Kuba-Dvorak/PCB_Maker/documentation/commProtocol.txt

========================================================================
 KOMUNIKACNI PROTOKOL
========================================================================

Retez: frontend (browser)  <--HTTP-->  backend (Node, port 3300)
       backend             <--TCP-->   nanoComm (C++, porty 5000 / 5001)
       nanoComm            <--UART-->  Nano (115200 8-N-1)

------------------------------------------------------------------------
 TCP mezi backendem a nanoComm
------------------------------------------------------------------------

port 5000 = prikazy a reporty
port 5001 = emergency

zacatek zpravy: $
konec zpravy:   \n

emergency znaky (port 5001):
  ; = pause
  # = stop

------------------------------------------------------------------------
 CMD cisla pro Nano
------------------------------------------------------------------------

0   ping / otestovani linky
1   jednoduchy move (X, Y)
2   nastaveni otacek spindlu
3   homing na MIN vsech osy
4   homing na MAX vsech osy
5   zvednout Z, pak jet (pokracovani v jobu)
6   vypnout spindl
7   ukonceni jobu: spindl off + homing na MAX
8   relativni move (prictene k aktualni pozici)
12  zadny prikaz, Nano preskoci a NEPOSILA report
25  interni: loadCMD nedokazal zpravu rozparsovat
255 stejne jako 7

POZOR: cmd 12 je jediny prikaz, ktery neposila report. Vsechny ostatni
report posilaji, a nanoComm na nej ceka v listenUART().

------------------------------------------------------------------------
 Emergency kody z frontendu
------------------------------------------------------------------------

stop:  4
end:   5   (dojede homing na max X, max Y, max Z)

------------------------------------------------------------------------
 Format reportu Nano -> nanoComm
------------------------------------------------------------------------

$status;error;x;y;z;speed;spindleSpeed;endstops;\n

Vsechny nekonstantni ciselne polozky krome status/error/endstops se
posilaji jako CELE CISLO vynasobene 100 (float printf na avr-libc bez
-lprintf_flt tiskne jen '?'). nanoComm je pri parsovani deli zpet 100.

Priklad: X = 12.34 mm  ->  1234

------------------------------------------------------------------------
 POTVRZOVANI (UART, obema smery)
------------------------------------------------------------------------

Kazdy prikaz i kazdy report se pred pouzitim posle zpatky a porovna.
Nic se neprovede ani nepouzije, dokud druha strana nepotvrdi, ze prijala
to, co se poslalo. Nahrazuje to drivejsi paritu, ktera hlidala jen cislo
prikazu, status, error a endstopy - souradnice ne.

Ramec na UARTu:  $$$ <data> \n\n\n
  Prijemci staci najit aspon jeden '$' - kdyz rusi poskodi prvni jeden
  nebo dva, ramec se porad pozna. Za '$' parser preskoci vsechno, co neni
  cislice, a skoci rovnou na prvni cislo. Konec: kdyz se prvni '\n'
  poskodi, ramec ukonci druhy.
  (TCP ramec mezi nanoComm a backendem je dal $<json>\n, ten se nemenil.)

Prikaz (nanoComm -> Nano):
  1. nanoComm posle   $$$cmd;x;y;z;speed;spindleSpeed;\n\n\n   (floaty, %f)
  2. Nano posle echo  $$$cmd;x;y;z;speed;spindleSpeed;\n\n\n   (cela cisla
                      x100, zaokrouhlena lround)
  3. nanoComm porovna (sameCMDs, tolerance 0.05) a posle potvrzeni
  4. Nano prikaz provede jen na "ano". Na "ne", na timeout (1 s) i na
     cokoliv, co nevypada jako potvrzeni, ho zahodi bez reportu.
     nanoComm ho po "ne" posle znovu.

  Tolerance 0.05: v XY je to min nez jeden krok (0.08 mm), takze takova
  odchylka stroj stejne nepohne jinam. V Z je to ale 10 kroku (krok
  0.005 mm) - radove tloustka medi na desce (35 um).

Report (Nano -> nanoComm):
  1. Nano posle report (tvar viz vys, jen s $$$ a \n\n\n)
  2. nanoComm posle echo  $$$status;error;x;y;z;speed;spindl;endstops;\n\n\n
                          (x..spindl uz v mm, floaty %f)
  3. Nano porovna v setinach (sameReports: long(x*100) == lround(echo*100),
     takze bez tolerance) a posle potvrzeni
  4. Na "ne" nebo kdyz echo neprijde, posle Nano report znovu - nejvys
     maxReportAttempts = 3 krat, pak to vzda a ceka na dalsi prikaz.
     Nano nesmi viset: kdyby nanoComm report necetl, nevzalo by uz nic.

Potvrzeni:  $$$ + 14x stejna cifra + \n\n\n,  tedy 20 B
            1 = ano, 0 = ne. Rozhoduje vetsina (hasMajority), remiza je ne.
            Presna delka se nehlida - rusi muze bajt zahodit nebo pridat.
            Za potvrzeni se ale bere jen ramec BEZ ';' (prikaz i report ho
            maji vzdy) a na Nanu jen s aspon 10 ciframi 0/1.

Velikosti jsou na obou stranach stejne:
  largeMessageStandart        80   nejdelsi ramec ma i s $$$ a \n\n\n 66 B
                                   (echo reportu od nanoComm)
  conformationMessageStandart 20   potvrzeni

ZNAMA DIRA: kdyz se ztrati cele potvrzeni prikazu, nanoComm si mysli
"ano", Nano "ne". Nano prikaz neprovede a nanoComm ceka na report, ktery
neprijde - az do timeoutu v listenUART (error 17). Nic spatneho se
neprovede, jen se to zastavi.

------------------------------------------------------------------------
 STATUS - kdo report poslal
------------------------------------------------------------------------

0   Nano
1   nanoComm (C++)
2   backend (JS)
3   frontend (browser)

Status 3 se po drate nikdy neposle. Dopisuje si ho stranka sama v okamziku,
kdy spojeni s backendem nestoji - tedy kdyz uz nema od koho zadny report
dostat. Vsechna cisla na strance jsou pak posledni znamy stav, ne aktualni,
a koncaky jdou do sedive.

Status je nutny k precteni erroru. Stejne cislo erroru znamena u kazdeho
zdroje neco jineho (napr. 6 a 7 se pouzivaji u Nana i u nanoComm jinak).

------------------------------------------------------------------------
 ERROR kody
------------------------------------------------------------------------

--- status 0, hlasi Nano -----------------------------------------------

0    OK, prikaz dobehl bez problemu
3    Nano neumelo prijatou zpravu rozparsovat (poskozeny frame)
4    odpoved na ping (neni to chyba, jen potvrzeni ze Nano zije)
5    nezname cislo prikazu
6    cil byl mimo pracovni prostor, byl clampnuty na nejblizsi hranu
     -> stroj jel jinam, nez frontend chtel
7    behem pohybu byl stisknut koncak, nebo stroj nikdy nebyl homovany
     -> reportovana pozice uz neni verohodna, je potreba homovat
8    ukonceni jobu: spindl vypnuty, vsechny osy homovane na max
10   stisknuto emergency tlacitko (hardwarovy interrupt)
     -> motory a spindl vypnute, timer1 zastaveny

--- status 1, hlasi nanoComm (C++) -------------------------------------

0    OK, komunikace bezi
1    pozadovany soubor s G-kodem nebyl nalezen na disku
2    UART je uz obsazeny, prikaz byl zahozeny
3    pohyb odmitnut, stroj neni homovany (prikaz se na UART vubec neposlal)
6    Nano se odpojilo od serioveho portu pri cteni reportu
7    seriovy port neni otevreny
10   job skoncil driv, nez dosel soubor: Nano vratilo chybu, nebo uz
     neodpovida. Spindl ani homing uz se neresi, job je pryc.
17   od Nana neprisel cely report do timeoutu listenUART (600 s,
     pri opakovani 60 s). Nano je zaseknute, odpojene, nebo se ztratilo
     potvrzeni prikazu - viz ZNAMA DIRA u potvrzovani.
11   job dojel az na konec souboru, odeslan cmd 7/255
     -> spindl vypnuty a vsechny osy homovane na max

Dve cisla nejsou chyby, jen znacky. Nesou informaci navic a poznaji se
prave podle toho cisla, jinak vypadaji jako obycejny report:

162  odhad celkoveho casu jobu. nanoComm kazdych 40 volani doGcodeTask
     zmeri, kolik casu zatim ubehlo; cas/40 * pocet radku souboru da
     odhad celku. Pocet radku drzi gcodeDecoder (totalLines).
163  prereport - stav, ktery nanoComm posle dopredu, jeste nez ho
     potvrdi Nano. Backend ho nezapisuje do currentReport, jen ho
     preposle na frontend jako cmdBE 3. Slouzi k vykresleni, ne k
     hlaseni stavu.

--- status 2, hlasi backend (JS) ---------------------------------------

0    backend jeste nedostal zadny report ze stroje
1    frontend poslal neco, co neni platny JSON
2    frontend poslal prikaz, kteremu backend nerozumi
     (nezname cmd nebo subCmd, chybejici cislo)
3    prikaz odmitnut, prave bezi job
     -> jog i homing jsou behem jobu zamcene. Behem PAUZY povolene jsou,
        prave kvuli vymene hrotu.
4    G-kod se nepodarilo vygenerovat, tisk nezacal
5    prikaz se nikam neodeslal, nanoComm neni pripojeny
33   nanoComm poslal neco, co neni platny JSON
34   nanoComm poslal zpravu bez uvodniho znaku $

Cisla 1 az 5 vznikaji v backendu jeste pred tim, nez se ke stroji cokoliv
posle. Ke stroji se v tu chvili nic nedostalo, takze by na report nebylo
od koho cekat - proto si ho backend posle sam.

--- status 3, hlasi frontend -------------------------------------------

0    spojeni s backendem jeste nebylo navazano (stranka se prave otevrela)
1    spojeni s backendem se zavrelo
2    spojeni s backendem se nepodarilo otevrit
     -> bezi server vubec, a sedi adresa v connectedURL?

------------------------------------------------------------------------
 ENDSTOPS - bitova maska stisku koncaku
------------------------------------------------------------------------

Osma polozka reportu. Bitova maska, ktera rika, ktere koncaky byly
stisknute BEHEM POSLEDNIHO PRIKAZU. Je latchovana (sticky): staci jeden
stisk kdykoliv v prubehu pohybu a bit zustane nastaveny az do dalsiho
prikazu. Nezajima nas kolikrat, jen jestli vubec.

  bit 0   hodnota 1    X min   (esXFront)
  bit 1   hodnota 2    X max   (esXEnd)
  bit 2   hodnota 4    Y min   (esYFront)
  bit 3   hodnota 8    Y max   (esYEnd)
  bit 4   hodnota 16   Z min   (esZFront)
  bit 5   hodnota 32   Z max   (esZEnd)

  0    zadny koncak nebyl stisknuty
  -1   stav koncaku neni znamy (backend jeste nic nedostal, nebo report
       polozku endstops neobsahoval)

Poradi bitu kopiruje poradi parametru v setupPins(): front (min) pak
end (max), a osy X -> Y -> Z.

Priklad: 9 = 1 + 8 = behem posledniho pohybu byl stisknuty X min a Y max.

Kde se maska nastavuje:
  - nuluje se v operateInstr() vedle currentError = 0
  - OR-uje se v interuptX/Y/Z() tam, kde se uz dneska nastavuje
    homed = false

Proc samostatna polozka a ne cast erroru: error potrebuje 4 bity
(hodnoty 0-10), maska 6 bitu, dohromady 10 bitu a to se do jednoho
bajtu nevejde. Frame ma navic misto - typicky report ma ~36 znaku
pri bufferu 64 B, takze jedna polozka navic je bezpecna.

------------------------------------------------------------------------
 Poznamka k zapojeni koncaku
------------------------------------------------------------------------

Koncaky jsou na INPUT_PULLUP a firmware cte LOW = stisknuto. Z toho
plyne, ze NA D13 KONCAK NESMI BYT: na Nanu je tam onboard LED zapojena
primo (na rozdil od Uno R3, kde je mezi tim buffer), interni pullup ji
neprepere a pin cte natrvalo LOW. Osa pak stoji a nikdy neudela krok.

Zapojeni je NO (rozpinaci do GND), takze "nestisknuto" = HIGH. Preruseny
kabel proto vypada jako "vse v poradku" - stroj tise prijde o ochranu.
NC zapojeni selhava bezpecnym smerem, je to jen otoceni podminky
v interupt*().
