Kuba-Dvorak/PCB_Maker/documentation/protocolBackFronNano.txt

$$$
status: "int", error: "int", x: "float", y: "float", z: "float", speed: "float", spindlSpeed: "float", endstops: "uint_8"
\n\n\n
