Kuba-Dvorak/PCB_Maker/documentation/protocolForNano.txt

$$$
cmd: "int", x: "float", y: "float", z: "float", speed: "float", spindleSpeed: "float"
\n\n\n
