Kuba-Dvorak/PCB_Maker/obrazek2.png

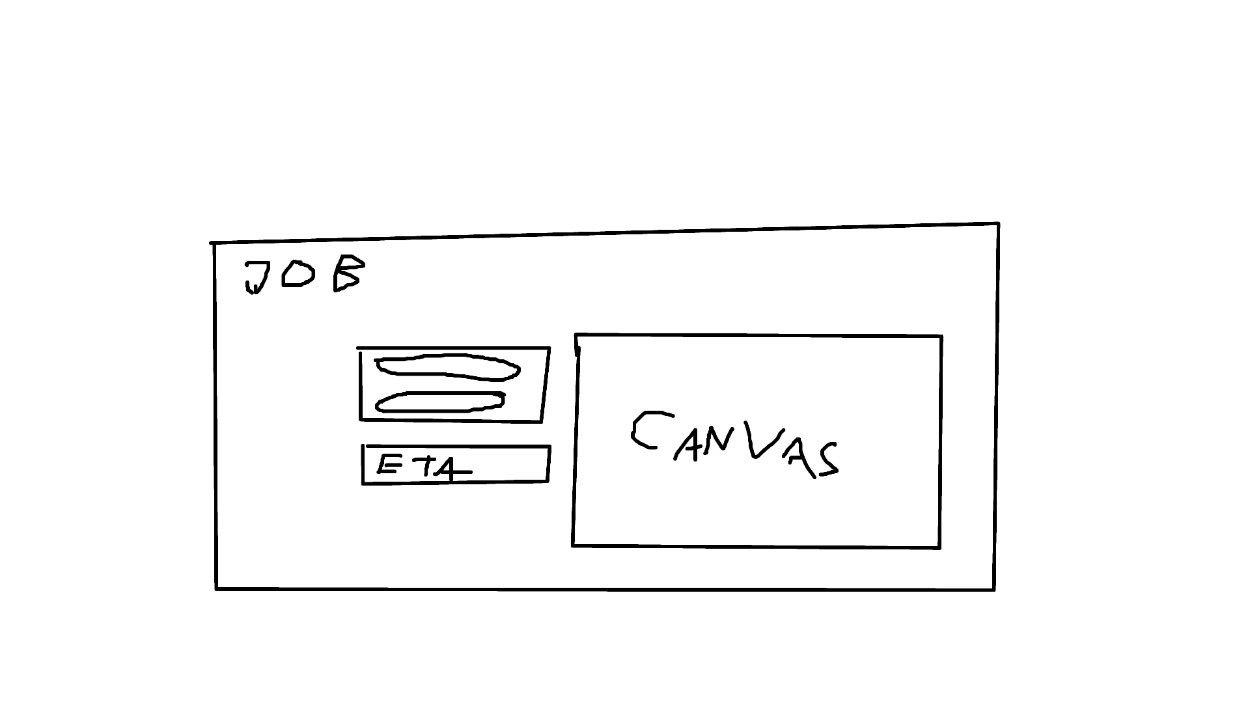
obrazek2.png
