Kuba-Dvorak/PCB_Maker/obrazek3.png

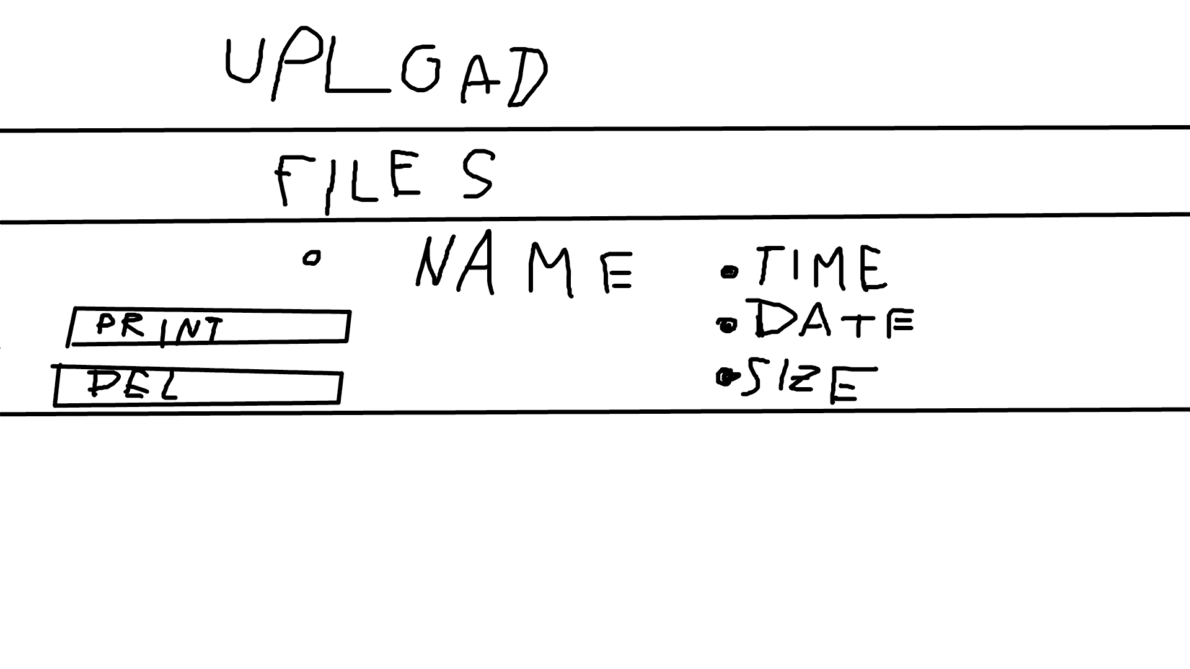
obrazek3.png
