Kuba-Dvorak/PCB_Maker/obrazek4.png

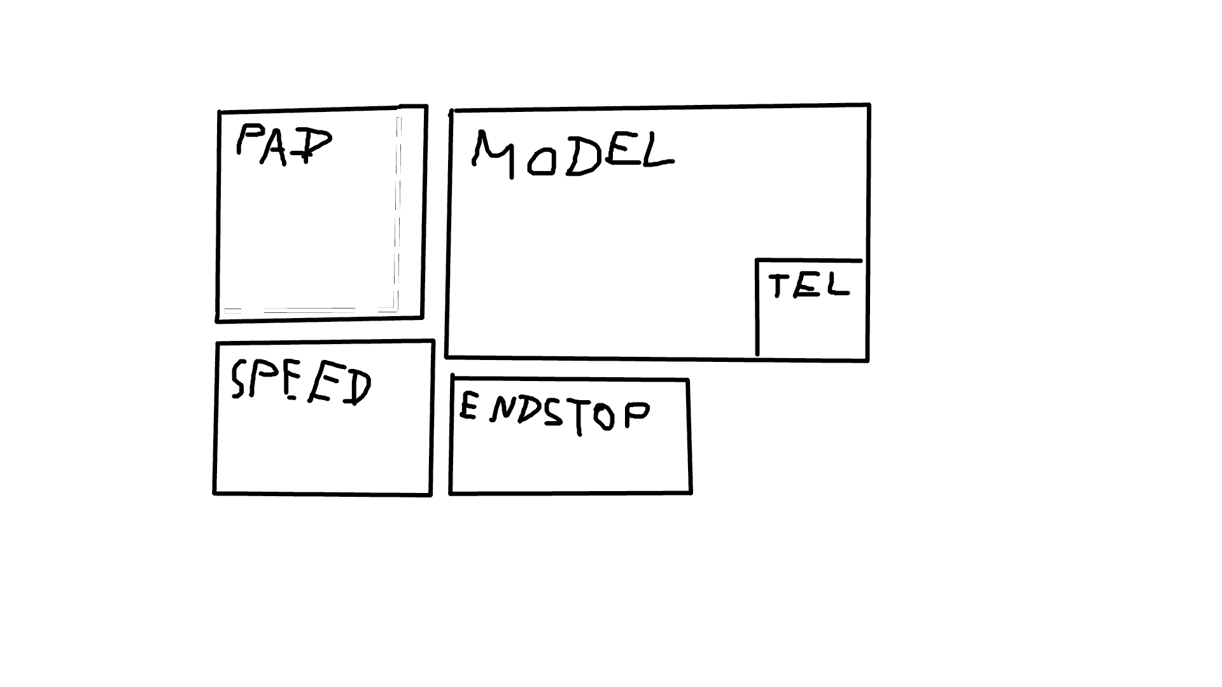
obrazek4.png
