Kuba-Dvorak/PCB_Maker/obrazek.png

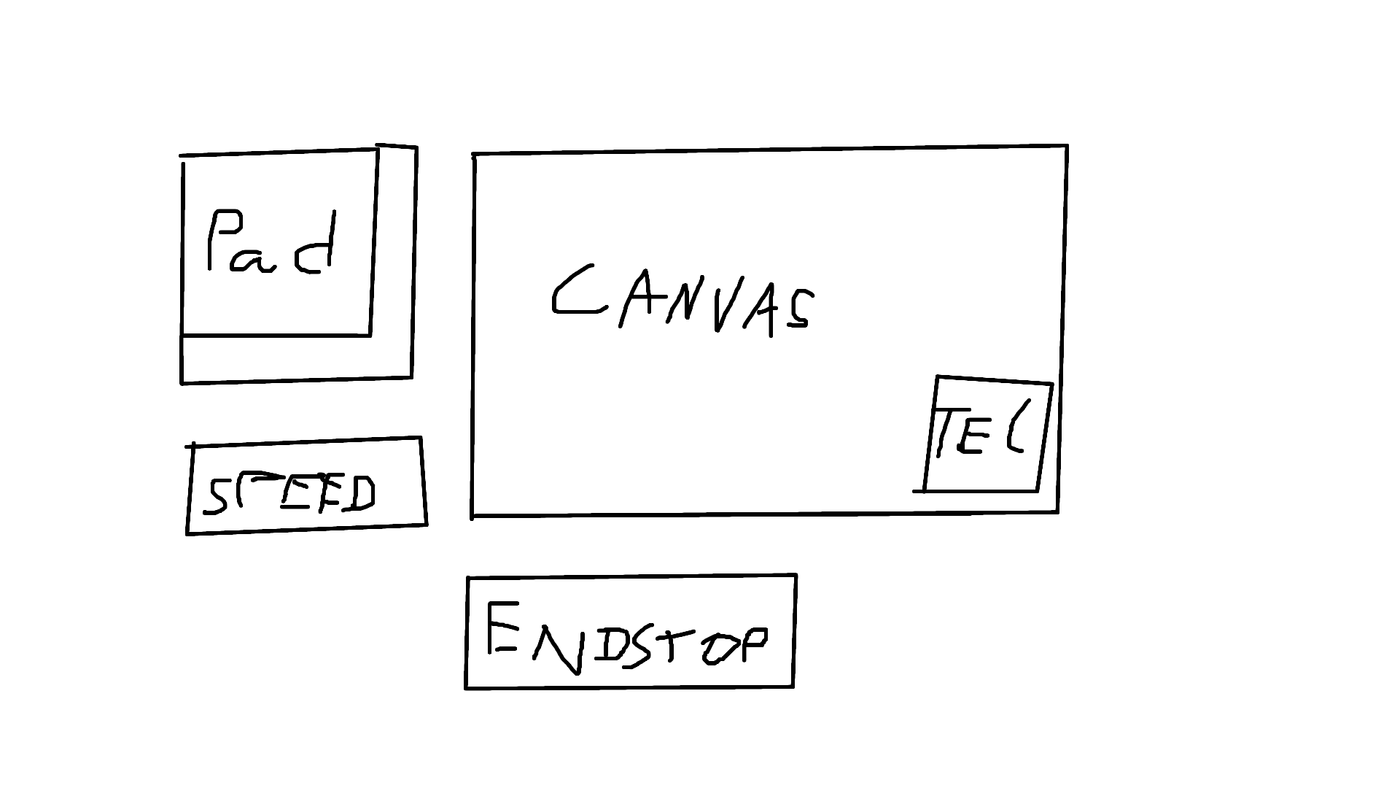
obrazek.png
