Kuba-Dvorak/PCB_Maker/showimage2.png

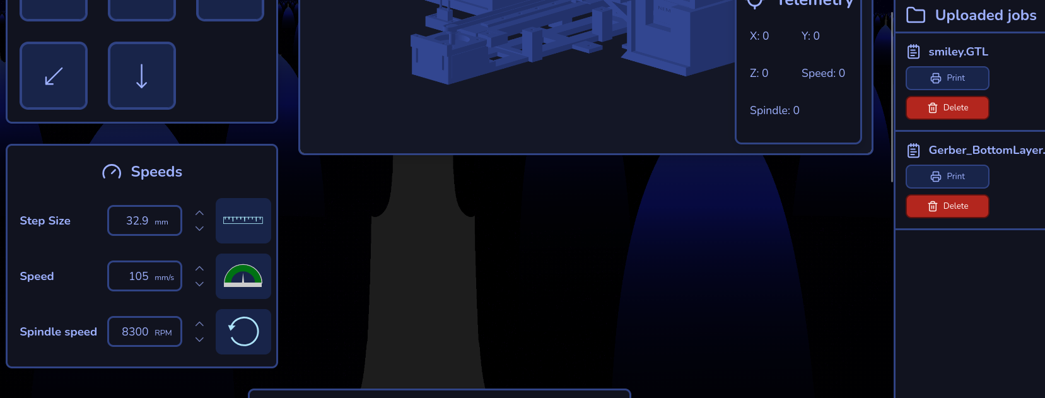
showimage2.png
