Kuba-Dvorak/PCB_Maker/showObraz3.png

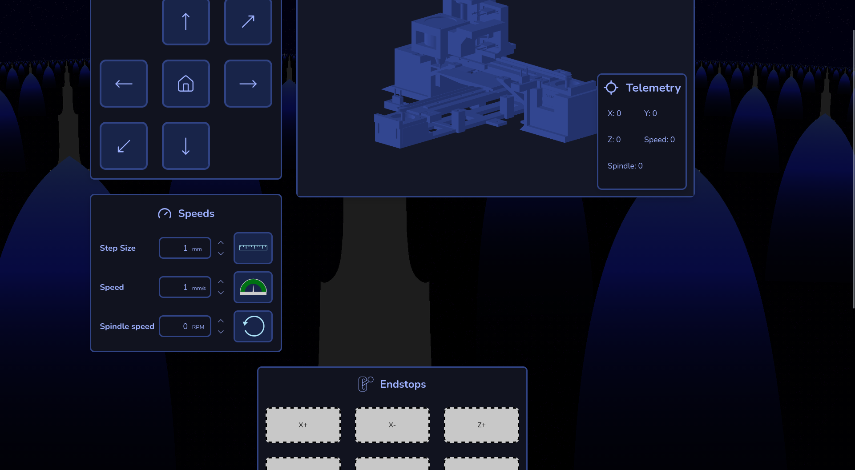
showObraz3.png
