Kuba-Dvorak/PCB_Maker/showobrazek.png

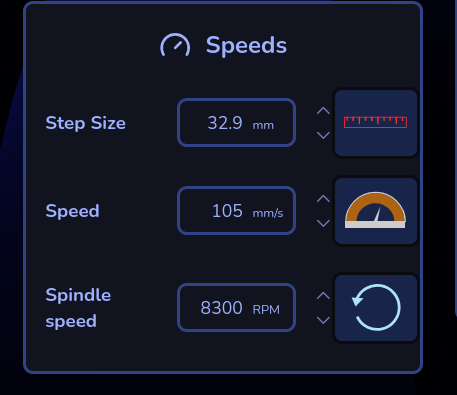
showobrazek.png
