Kuba-Dvorak/PCB_Maker/webdisajn2.png

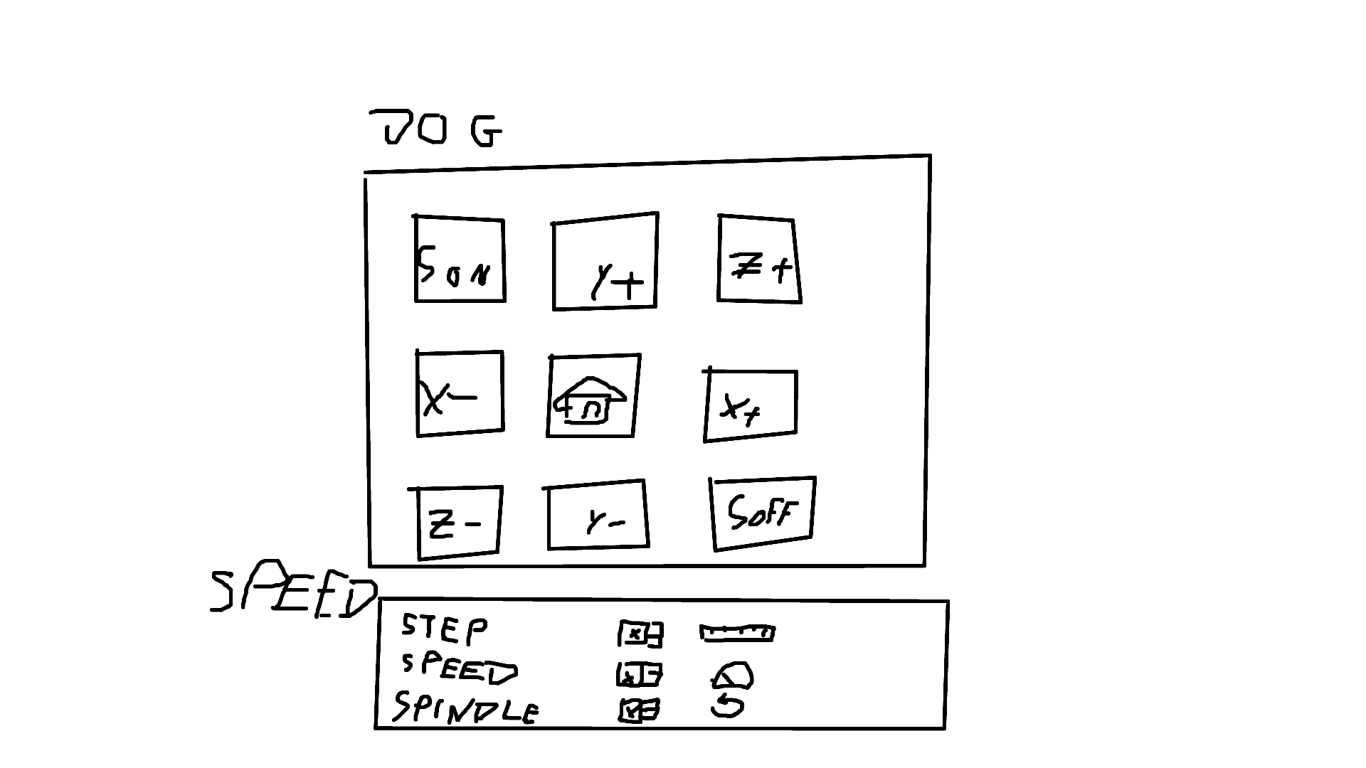
webdisajn2.png
