Kuba-Dvorak/PCB_Maker/webDisajn.png

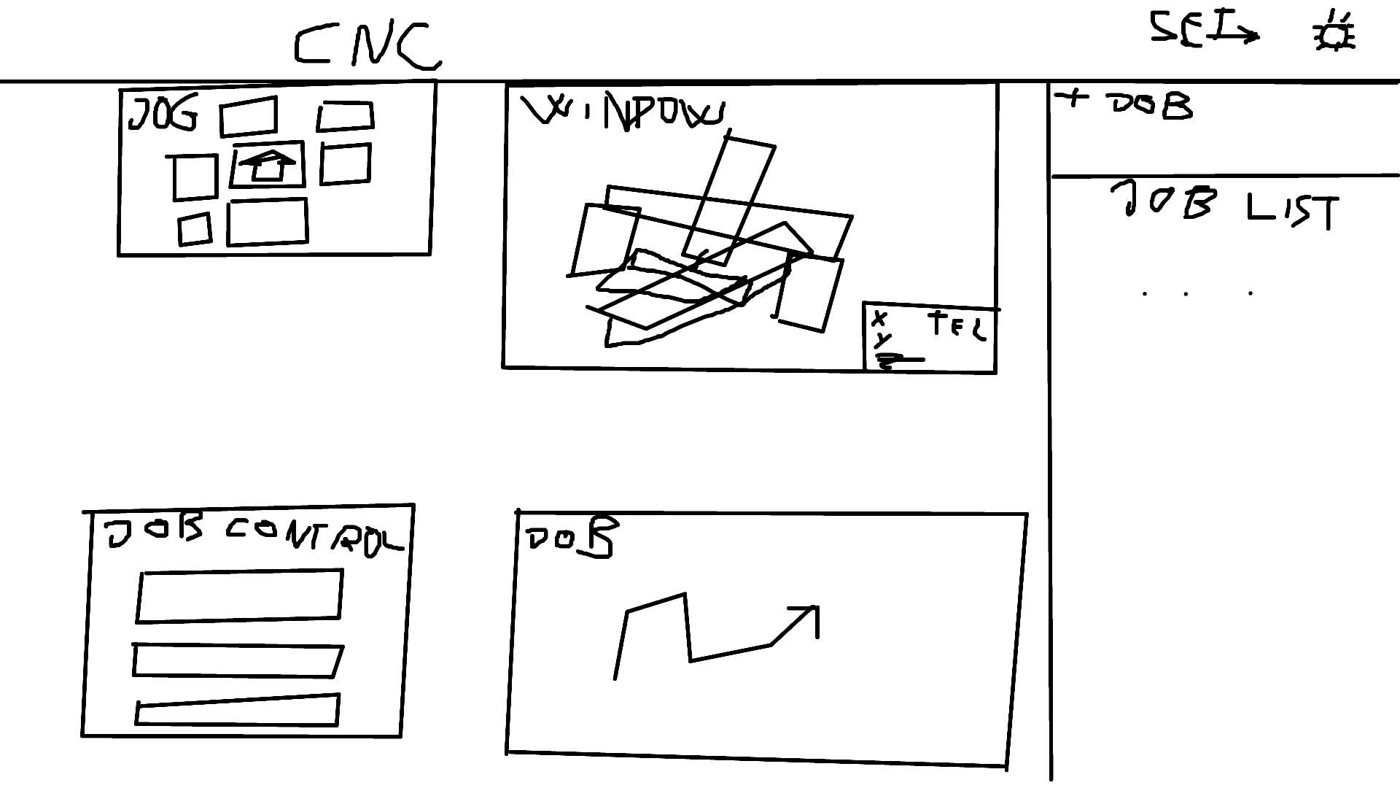
webDisajn.png
