Kuba-Dvorak/PCB_Maker/webUI/frontend/backgrounds-default/ComplexGraph.png

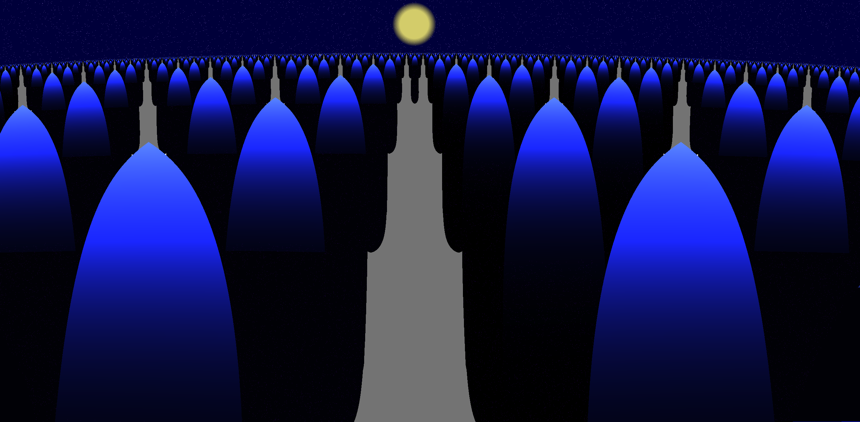
webUI/frontend/backgrounds-default/ComplexGraph.png
