Kuba-Dvorak/PCB_Maker/models/idlerHolderXaxis.stl

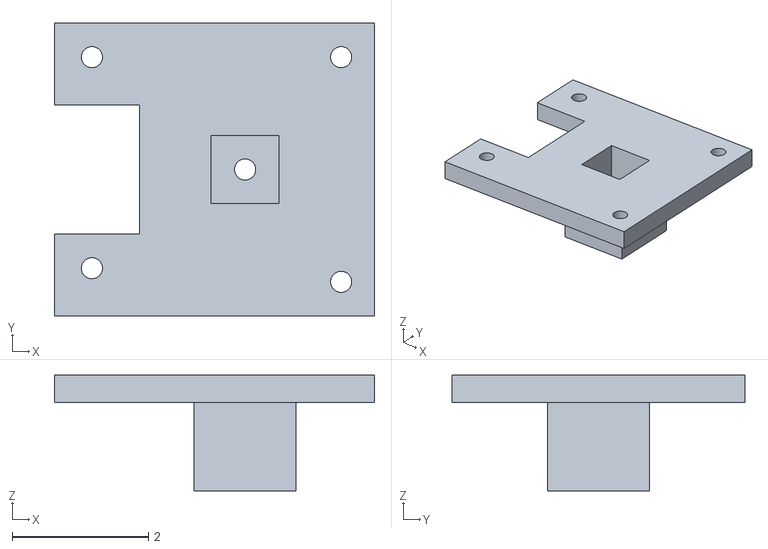
[picture p11: CAD file, 2026-07-24]
models/idlerHolderXaxis.stl
4.70 x 4.30 x 1.70
