Kuba-Dvorak/PCB_Maker/webUI/frontend/models/cartX.stl

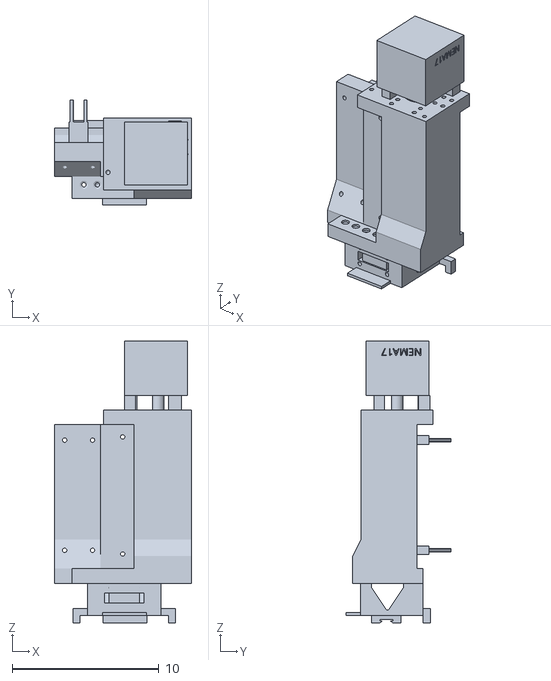
[picture p12: CAD file, 2026-09-15]
webUI/frontend/models/cartX.stl
9.34 x 7.15 x 19.2
