Kuba-Dvorak/PCB_Maker/models/motorHolderTop.stl

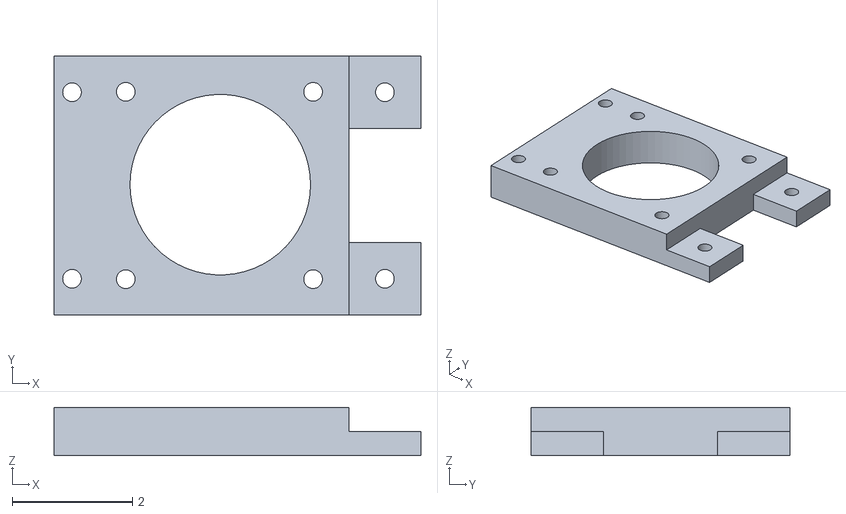
[picture p13: CAD file, 2026-07-06]
models/motorHolderTop.stl
6.10 x 4.30 x 0.8
