Kuba-Dvorak/PCB_Maker/webUI/frontend/models/cartZ.stl

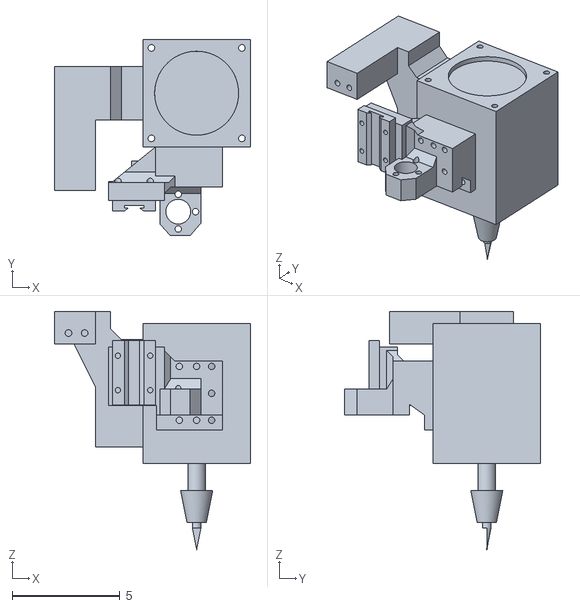
[picture p14: CAD file, 2026-09-15]
webUI/frontend/models/cartZ.stl
9.10 x 9.11 x 11.1
