Kuba-Dvorak/PCB_Maker/models/motorHolderBottom.stl

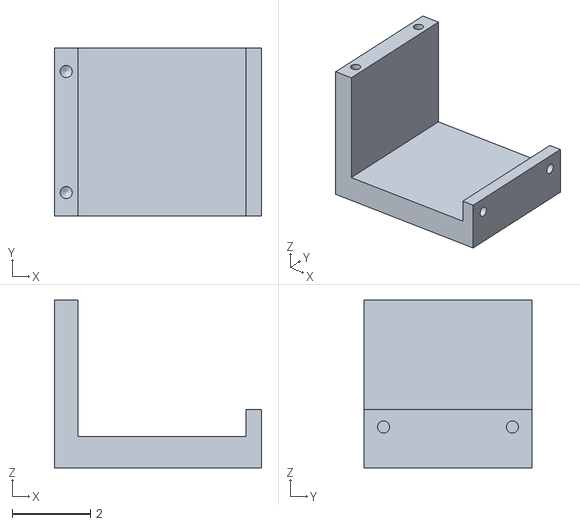
[picture p15: CAD file, 2026-07-06]
models/motorHolderBottom.stl
5.30 x 4.30 x 4.30
