Kuba-Dvorak/PCB_Maker/webUI/frontend/models/cartY.stl

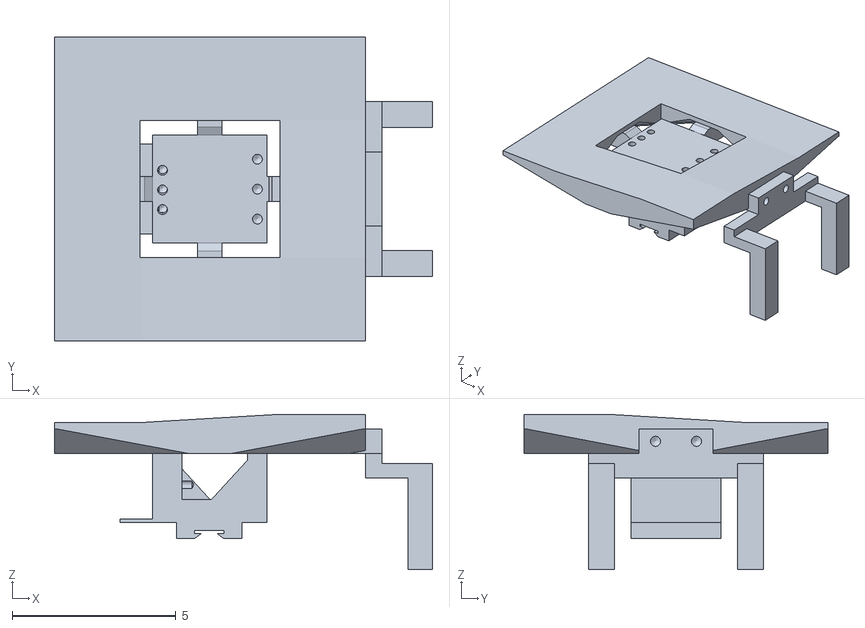
[picture p16: CAD file, 2026-09-15]
webUI/frontend/models/cartY.stl
11.6 x 9.30 x 4.75
