Kuba-Dvorak/PCB_Maker/models/rail.stl

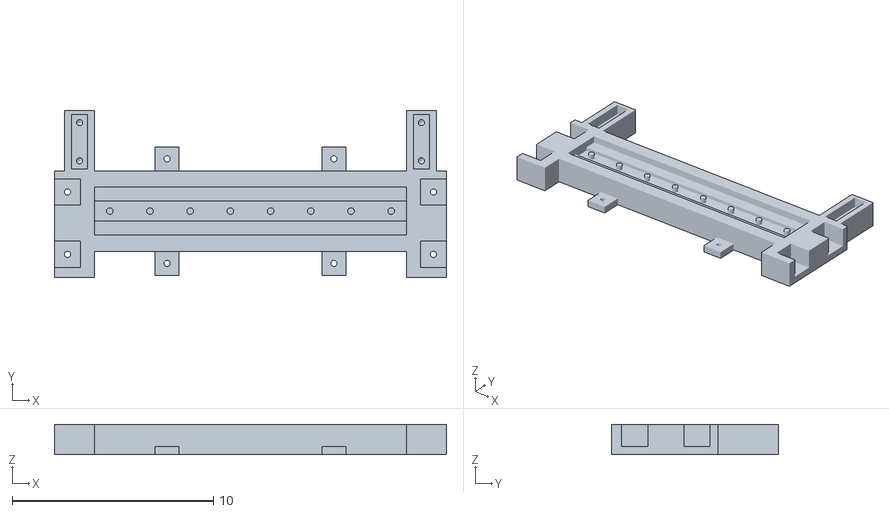
[picture p17: CAD file, 2026-07-06]
models/rail.stl
19.5 x 8.30 x 1.50
