Kuba-Dvorak/PCB_Maker/webUI/frontend/models/staticPart.stl

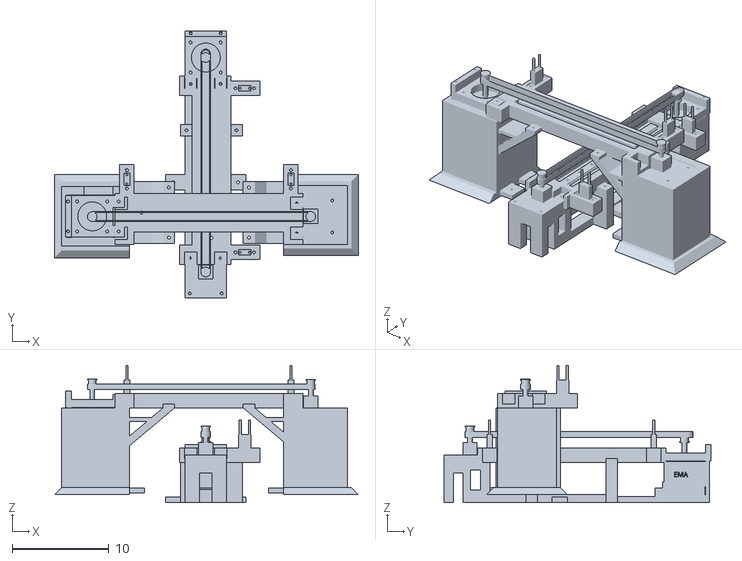
[picture p18: CAD file, 2026-09-15]
webUI/frontend/models/staticPart.stl
31.5 x 27.7 x 14.2
