Kuba-Dvorak/PCB_Maker/models/EndstopPin.stl

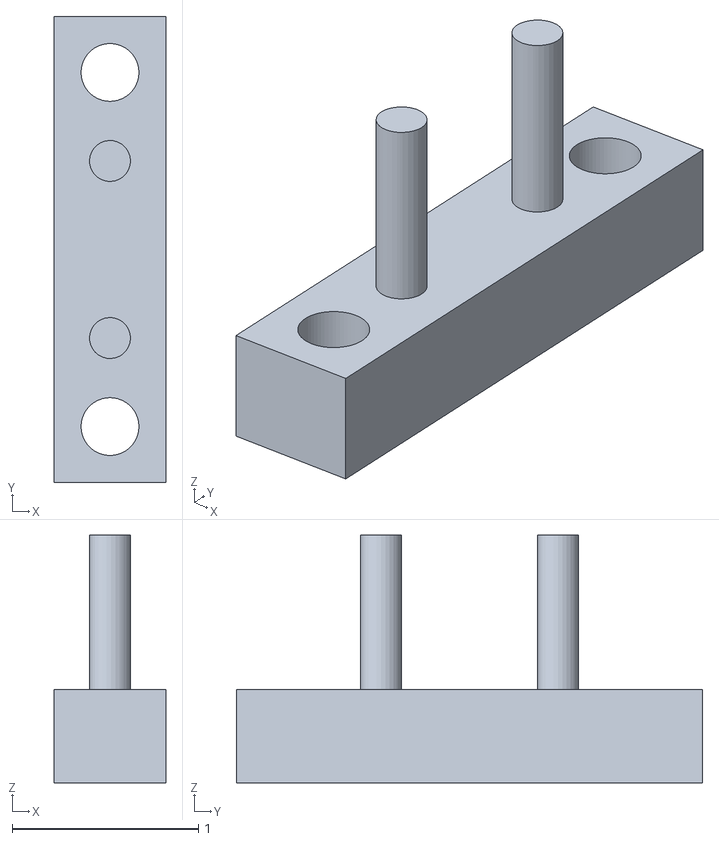
[picture p19: CAD file, 2026-07-06]
models/EndstopPin.stl
0.6 x 2.50 x 1.33
