Kuba-Dvorak/PCB_Maker/models/beltclampSmall.stl

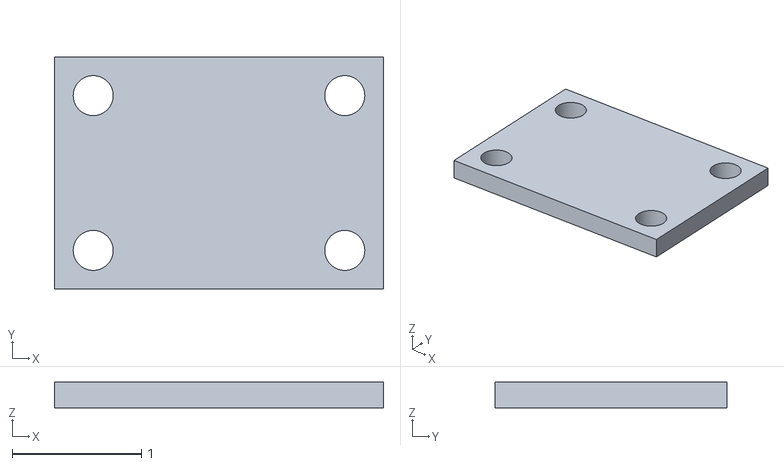
[picture p20: CAD file, 2026-07-06]
models/beltclampSmall.stl
2.55 x 1.80 x 0.2
