Kuba-Dvorak/PCB_Maker/models/beltClamp.stl

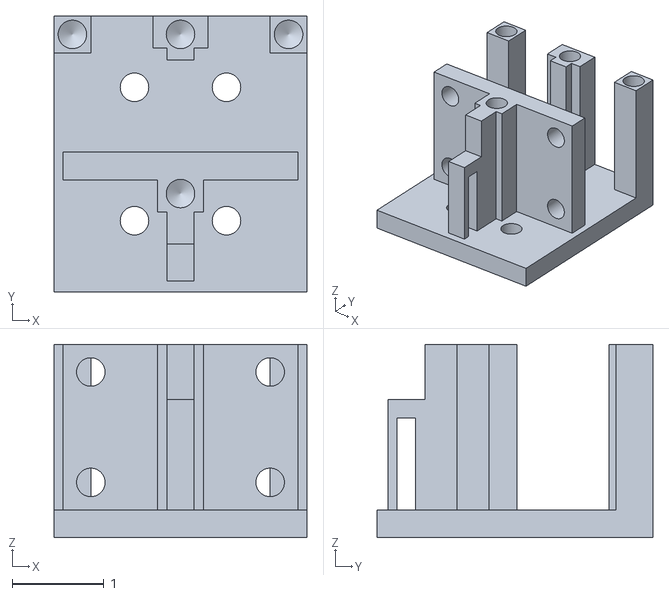
[picture p21: CAD file, 2026-07-06]
models/beltClamp.stl
2.75 x 3.00 x 2.10
