Kuba-Dvorak/PCB_Maker/models/base.stl

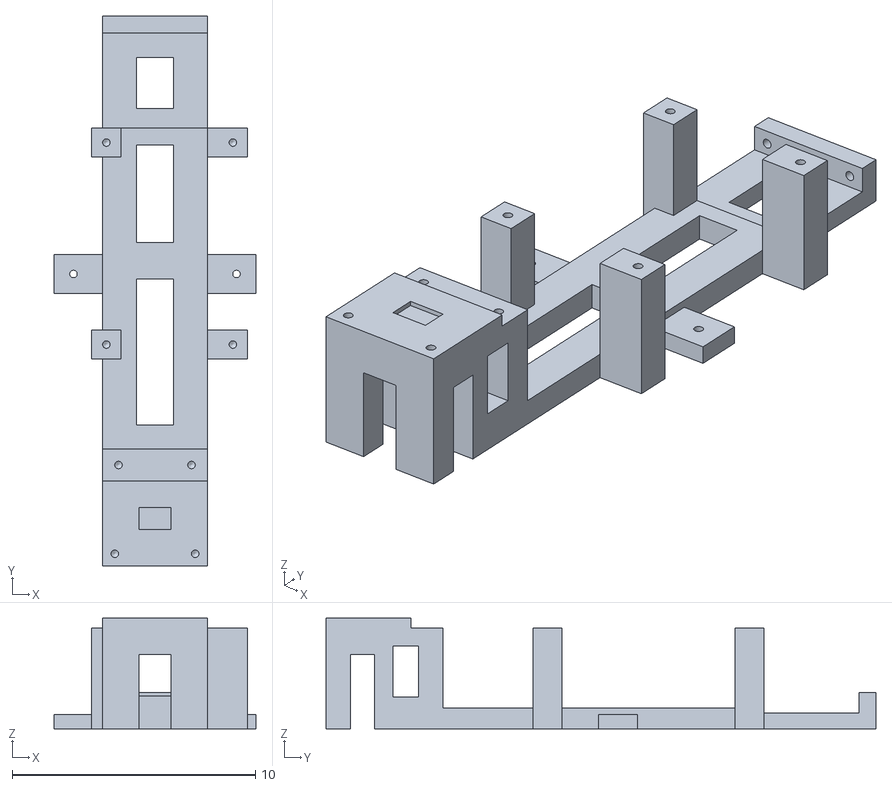
[picture p22: CAD file, 2026-07-06]
models/base.stl
8.30 x 22.6 x 4.55
