Kuba-Dvorak/PCB_Maker/pcb_for_cnc_for_pcb/board/board.kicad_pcb

## KiCad design pcb_for_cnc_for_pcb/board/board.kicad_pcb (2026-09-08)

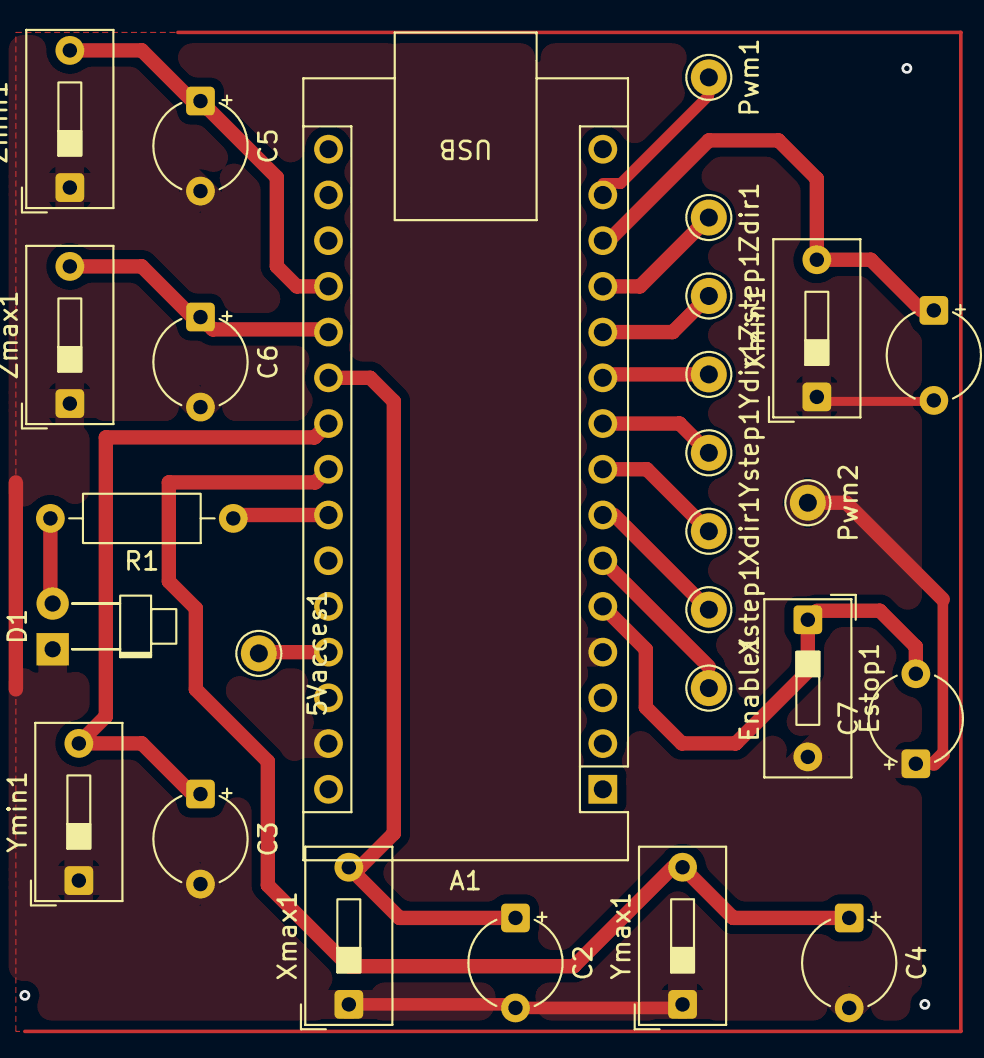
[picture p23: board board.kicad_pcb from above]

Board: 2 copper layers, 27 parts (0 on the bottom side), 19 nets.

Parts:
5Vacces1: TestPoint; Pin_D1.0mm_L10.0mm
A1: arduino; Arduino_Nano
C1, C2, C3, C4, C5, C6, C7: C_Small; CP_Radial_Tantal_D5.0mm_P5.00mm
D1: LED; LED_D1.8mm_W1.8mm_H2.4mm_Horizontal_O3.81mm_Z1.6mm
Enable1: TestPoint; Pin_D1.0mm_L10.0mm
Estop1: SW_Push; SW_DIP_SPSTx01_Slide_9.78x4.72mm_W7.62mm_P2.54mm
Pwm1, Pwm2: TestPoint; Pin_D1.0mm_L10.0mm
R1: R; R_Axial_DIN0207_L6.3mm_D2.5mm_P10.16mm_Horizontal
Xdir1: TestPoint; Pin_D1.0mm_L10.0mm
Xmax1: SW_Push; SW_DIP_SPSTx01_Slide_9.78x4.72mm_W7.62mm_P2.54mm
Xmin1: SW_Push; SW_DIP_SPSTx01_Slide_9.78x4.72mm_W7.62mm_P2.54mm
Xstep1: TestPoint; Pin_D1.0mm_L10.0mm
Ydir1: TestPoint; Pin_D1.0mm_L10.0mm
Ymax1: SW_Push; SW_DIP_SPSTx01_Slide_9.78x4.72mm_W7.62mm_P2.54mm
Ymin1: SW_Push; SW_DIP_SPSTx01_Slide_9.78x4.72mm_W7.62mm_P2.54mm
Ystep1: TestPoint; Pin_D1.0mm_L10.0mm
Zdir1: TestPoint; Pin_D1.0mm_L10.0mm
Zmax1: SW_Push; SW_DIP_SPSTx01_Slide_9.78x4.72mm_W7.62mm_P2.54mm
Zmin1: SW_Push; SW_DIP_SPSTx01_Slide_9.78x4.72mm_W7.62mm_P2.54mm
Zstep1: TestPoint; Pin_D1.0mm_L10.0mm

Connections:
unnamed: A1.19 (A0), C5.1, Zmin1.2
unnamed: A1.20 (A1), C6.1, Zmax1.2
unnamed: A1.21 (A2), C2.1, Xmax1.2
unnamed: A1.22 (A3), C3.1, Ymin1.2
unnamed: A1.5 (D2), C7.2, Estop1.1
unnamed: A1.6 (D3), Enable1.1 (1_1)
unnamed: A1.7 (D4), Xstep1.1 (1_1)
unnamed: A1.8 (D5), Xdir1.1 (1_1)
unnamed: A1.9 (D6), Ystep1.1 (1_1)
unnamed: A1.10 (D7), Ydir1.1 (1_1)
unnamed: A1.11 (D8), Zstep1.1 (1_1)
unnamed: A1.12 (D9), Zdir1.1 (1_1)
unnamed: A1.13 (D10/CS), C1.1, Xmin1.2
unnamed: A1.14 (D11/COPI), Pwm1.1 (1_1)
unnamed: A1.24 (SCL/A5), R1.1
unnamed: A1.23 (SDA/A4), C4.1, Ymax1.2
unnamed: 5Vacces1.1 (1_1), A1.27 (VUSB/5V)
unnamed: D1.2 (A), R1.2
unnamed: A1.4 (GND), A1.29 (GND), C1.2, C2.2, C3.2, C4.2, C5.2, C6.2, C7.1, D1.1 (K), Estop1.2, Pwm2.1 (1_1), Xmax1.1, Xmin1.1, Ymax1.1, Ymin1.1, Zmax1.1, Zmin1.1
