Kuba-Dvorak/PCB_Maker/nanoCode/src/main.cpp

#include <Arduino.h>
#include <Wire.h>
#include "cctype"
#include "cmath"
#include "vector"
#include "array"


#define EMERGENCY_PIN 2
#define LEAD_T8 2
#define JUMPER 2
#define PULLEY_TEETH 16
#define MAX_X 60
#define MAX_Y 80
#define MAX_Z 8
#define MAX_SPEED 160
#define MAX_SPEED_Z 8
#define SPINDL_PIN 11
#define MINIMAL_DISTANCE_MM_X 3
#define MINIMAL_DISTANCE_MM_Y 2
#define MINIMAL_DISTANCE_MM_Z 1.5
#define MAX_ACC 150
#define START_FREQ 100


struct Position {
    float x, y;
};

//cmd 1 = jednoduchy move, cmd 0 = ping a otestovani, cmd 2 = nastaveni rychlosti spindl,
//cmd 3 = homing, cmd 4 = homing na MAX vseho, cmd 5 zvednout pak jet, cmd 6 stop spindl, cmd 7 konec, cmd 8 = localni move
struct basicCMD {
    uint8_t command;
    Position position;
    float z, speed, spindleSpeed;

    basicCMD(uint8_t cmd = 12, Position position = {-1, -1}, float z = -1, float speed = -1, float spindleSpeed = -1) {
        this->command = cmd;
        this->position = position;
        this->z = z;
        this->speed = speed;
        this->spindleSpeed = spindleSpeed;
    }

    //function created by Claude
    // Echo prijateho prikazu pro nanoComm. Stejny tvar jako report: cela cisla
    // v setinach, protoze avr-libc floaty netiskne. lround, ne long(): useknuti
    // by z 12.34 udelalo 12.33 a echo by se odeslanemu prikazu nepodobalo.
    void prepareForRPI(char buffer[], size_t bufSize) {
        // Ramec $$$ ... \n\n\n (zmena ramce: Claude). Prijemci staci najit aspon
        // jeden '$', cisla za nim si parser najde sam.
        int offset = 3;
        buffer[0] = '$';
        buffer[1] = '$';
        buffer[2] = '$';
        offset += snprintf(buffer + offset, bufSize - offset, "%d;", command);
        offset += snprintf(buffer + offset, bufSize - offset, "%ld;", lround(position.x * 100));
        offset += snprintf(buffer + offset, bufSize - offset, "%ld;", lround(position.y * 100));
        offset += snprintf(buffer + offset, bufSize - offset, "%ld;", lround(z * 100));
        offset += snprintf(buffer + offset, bufSize - offset, "%ld;", lround(speed * 100));
        offset += snprintf(buffer + offset, bufSize - offset, "%ld;", lround(spindleSpeed * 100));

        // Na konec se musi vejit tri '\n' a koncova nula.
        if (offset > (int)bufSize - 4) {
            offset = bufSize - 4;
        }

        buffer[offset++] = '\n';
        buffer[offset++] = '\n';
        buffer[offset++] = '\n';
        buffer[offset] = '\0';
    }
};


struct nanoReport {
    uint8_t status;
    uint8_t error;
    Position position;
    float z;
    float speed;
    float spindleSpeed;
    uint8_t endstops;

    nanoReport(uint8_t status = 0, uint8_t error = 0, Position position = {0, 0}, float z = 0, float speed = 0, float spindleSpeed = 0, uint8_t endstops = 0) {
        this->status = status;
        this->error = error;
        this->position = position;
        this->z = z;
        this->speed = speed;
        this->spindleSpeed = spindleSpeed;
        this->endstops = endstops;
    }

    void prepareForRPI(char buffer[], size_t bufSize) {
        // Ramec $$$ ... \n\n\n (zmena ramce: Claude). Prijemci staci najit aspon
        // jeden '$', cisla za nim si parser najde sam.
        int offset = 3;
        buffer[0] = '$';
        buffer[1] = '$';
        buffer[2] = '$';
        offset += snprintf(buffer + offset, bufSize - offset, "%d;", status);
        offset += snprintf(buffer + offset, bufSize - offset, "%d;", error);
        offset += snprintf(buffer + offset, bufSize - offset, "%ld;", long(position.x * 100));
        offset += snprintf(buffer + offset, bufSize - offset, "%ld;", long(position.y * 100));
        offset += snprintf(buffer + offset, bufSize - offset, "%ld;", long(z * 100));
        offset += snprintf(buffer + offset, bufSize - offset, "%ld;", long(speed * 100));
        offset += snprintf(buffer + offset, bufSize - offset, "%ld;", long(spindleSpeed * 100));
        offset += snprintf(buffer + offset, bufSize - offset, "%d;", endstops);

        // Na konec se musi vejit tri '\n' a koncova nula.
        if (offset > (int)bufSize - 4) {
            offset = bufSize - 4;
        }

        buffer[offset++] = '\n';
        buffer[offset++] = '\n';
        buffer[offset++] = '\n';
        buffer[offset] = '\0';
    }
};


struct motorNema17 {
    uint8_t stepPin, dirPin, endStopFrontPin, endStopEndPin;
    volatile uint8_t* portStep, *portESF, *portESE;
    bool movingAwayFromEndStop = false;
};


//function created by Claude, I was to lazy to think
void presetOCR1A(long &wantedFreq, uint8_t &presetTCCR1Bs, uint16_t &presetOCR1A) {
    // prescalery Timeru1, od nejmenšího (nejmenší = nejjemnější rozlišení)
    static const struct { uint16_t prescaler; uint8_t csBits; } opts[] = {
        {1,    (1 << CS10)},
        {8,    (1 << CS11)},
        {64,   (1 << CS11) | (1 << CS10)},
        {256,  (1 << CS12)},
        {1024, (1 << CS12) | (1 << CS10)},
    };

    if (wantedFreq < 1) wantedFreq = 1;

    for (uint8_t i = 0; i < 5; i++) {
        long base  = (long)(F_CPU / opts[i].prescaler);
        long ticks = (base + wantedFreq / 2) / wantedFreq;   // zaokrouhli na nejbližší
        if (ticks < 1) ticks = 1;
        long ocr = ticks - 1;

        if (ocr <= 65535) {                                  // vejde se do 16 bitů?
            presetOCR1A = (uint16_t)ocr;
            presetTCCR1Bs = (1 << WGM12) | opts[i].csBits;     // CTC + zvolený prescaler
            wantedFreq = base / ticks;   // ZAPÍŠEME ZPĚT skutečně dosaženou frekvenci
            return;
        }
    }

    // frekvence nižší, než zvládne i /1024 → nejpomalejší možné nastavení
    presetOCR1A = 65535;
    presetTCCR1Bs = (1 << WGM12) | (1 << CS12) | (1 << CS10);
    wantedFreq = (long)(F_CPU / 1024) / 65536L;
}


struct calibration {
    float stepTime;
    float stepLenghtGT2, stepLenghtT8; // pocet kroku na 1 mm!!!!
    uint8_t leadT8;
    volatile int curStepX, curStepY, curStepZ;
    volatile int maxStepX, maxStepY, maxStepZ;
    motorNema17 motorX, motorY, motorZ;
    volatile uint8_t enablePin;
    volatile uint32_t counterX, counterY, counterZ;
    volatile uint32_t counterXMax, counterYMax, counterZMax;
    volatile uint32_t constantX, constantY, constantZ;
    volatile uint32_t countingX, countingY, countingZ;
    volatile uint16_t maxSpeedX, maxSpeedY, maxSpeedZ; // in mm/s
    volatile uint16_t rampingUpX, rampingUpY, rampingUpZ;
    volatile uint8_t maxX, maxZ, maxY;
    uint8_t pulleyNumTeeth; // how many teeth does the pulley have
    uint8_t jumperDown;
    uint8_t presetTCCR1B = 255;
    uint16_t presetOCR1As = 65535;
    volatile uint8_t clockX, clockY, clockZ;
    long masterFreq;
    volatile uint8_t finishedJob = 0;
    volatile uint8_t currentError = 0;
    volatile bool homed = false;
    uint16_t counter4Freq = 500;
    float timeConst;
    uint16_t stepAcc;
    uint16_t stepAccMax;
    uint16_t startCounter;
    volatile uint8_t stateRampUpX, stateRampUpY, stateRampUpZ;
    volatile uint16_t startStepsX, startStepsY, startStepsZ;
    volatile uint16_t endStepsX, endStepsY, endStepsZ;
    volatile uint8_t currentEndstopsError;
    volatile uint8_t ignoreEndstop;
    
    calibration(float maxAcc = MAX_ACC,uint16_t maxSpeedX = MAX_SPEED, uint16_t maxSpeedY = MAX_SPEED, uint16_t maxSpeedZ = MAX_SPEED_Z,
                uint8_t pulleyNumTeeth = PULLEY_TEETH, uint8_t jumperDown = JUMPER, uint8_t leadT8 = LEAD_T8, uint8_t maxX = MAX_X, uint8_t maxY = MAX_Y, uint8_t maxZ = MAX_Z) {
        this->maxSpeedX = maxSpeedX;
        this->maxSpeedY = maxSpeedY;
        this->maxSpeedZ = maxSpeedZ;
        this->pulleyNumTeeth = pulleyNumTeeth;
        this->jumperDown = jumperDown; // as in microsteps as 1/8 of a step
        this->leadT8 = leadT8; // for me
        this->maxX = maxX; // in mm, maximal physical limit in the lenght of the axis, of this contruction
        this->maxY = maxY;
        this->maxZ = maxZ;
        this->currentEndstopsError = 0;
        this->ignoreEndstop = 0;

        this->stepTime = 2; // in microsekunds

        // 001 = 2/200 (200 steps (nema17) and 2mm (GT2))
        this->stepLenghtGT2 = ((float)this->jumperDown * 200.0f) / ((float)this->pulleyNumTeeth * 2.0f);
        this->stepLenghtT8 = ((float)this->jumperDown * 200.0f) / ((float)this->leadT8);
    
        this->curStepX = 0;
        this->curStepY = 0;
        this->curStepZ = 0;

        //using GT2 = 2 mm and a classic nema 17 = 200 steps per rotation
        //master clock is 10 times bigger to allow for decimal clocking with bigger accuracy
        long wantedMaxFreq = 10UL * ((float)(std::max(std::max(this->maxSpeedX, this->maxSpeedY), this->maxSpeedZ)) / (float)(2 * this->pulleyNumTeeth)) * (this->jumperDown * 200);
        presetOCR1A(wantedMaxFreq, presetTCCR1B, presetOCR1As);
        this->masterFreq = wantedMaxFreq;
        this->startCounter = wantedMaxFreq / START_FREQ;
        this->stepAccMax = (masterFreq / counter4Freq) - 1;
        this->timeConst = (float)counter4Freq * MAX_SPEED / maxAcc;
        this->stepAcc = 0;
        this->maxStepX = (int)(this->stepLenghtGT2 * this->maxX);
        this->maxStepY = (int)(this->stepLenghtGT2 * this->maxY);
        this->maxStepZ = (int)(this->stepLenghtT8 * this->maxZ);
    }

    void setupFreqX(uint16_t freq) {
        clockX = 1;
        countingX = 0;
        counterXMax = (masterFreq / freq);
        constantX = (unsigned long)(((float)masterFreq / freq) * timeConst);
        counterX = masterFreq;
        stateRampUpX = 1;
        rampingUpX = (uint16_t)(((float)constantX / masterFreq) * 0.1f * (float)freq);
        if (rampingUpX <= 0) {
            rampingUpX = 1;
        }
        endStepsX = rampingUpX;
        startStepsX = 0;
    }

    void setupFreqY(uint16_t freq) {
        clockY = 1;
        countingY = 0;
        counterYMax = (masterFreq / freq);
        constantY = (unsigned long)(((float)masterFreq / freq) * timeConst);
        counterY = masterFreq;
        stateRampUpY = 1;
        rampingUpY = (uint16_t)(((float)constantY / masterFreq) * 0.1f * (float)freq);
        if (rampingUpY <= 0) {
            rampingUpY = 1;
        }
        endStepsY = rampingUpY;
        startStepsY = 0;
    }

    void setupFreqZ(uint16_t freq) {
        clockZ = 1;
        countingZ = 0;
        counterZMax = (masterFreq / freq);
        constantZ = (unsigned long)(((float)masterFreq / freq) * timeConst);
        counterZ = masterFreq;
        stateRampUpZ = 1;
        rampingUpZ = (uint16_t)(0.1f * timeConst);
        if (rampingUpZ <= 0) {
            rampingUpZ = 1;
        }
        endStepsZ = rampingUpZ;
        startStepsZ = 0;
    }

    void endFreqX() {
        countingX = 0;
        counterX = 0;
        clockX = 0;
    }

    void endFreqY() {
        countingY = 0;
        counterY = 0;
        clockY = 0;
    }

    void endFreqZ() {
        countingZ = 0;
        counterZ = 0;
        clockZ = 0;
    }

    //function created by Claude, I was to lazy to think
    void setupPins(uint8_t enablePinArg,
                    uint8_t stepXpin, uint8_t dirXpin, uint8_t esXFrontPin, uint8_t esXEndPin,
                    uint8_t stepYpin, uint8_t dirYpin, uint8_t esYFrontPin, uint8_t esYEndPin,
                    uint8_t stepZpin, uint8_t dirZpin, uint8_t esZFrontPin, uint8_t esZEndPin) {

        enablePin = enablePinArg;
        pinMode(enablePin, OUTPUT);
        pinMode(SPINDL_PIN, OUTPUT);

        motorX.dirPin = dirXpin;  pinMode(dirXpin, OUTPUT);
        motorY.dirPin = dirYpin;  pinMode(dirYpin, OUTPUT);
        motorZ.dirPin = dirZpin;  pinMode(dirZpin, OUTPUT);

        pinMode(stepXpin, OUTPUT);
        motorX.portStep = portOutputRegister(digitalPinToPort(stepXpin));
        motorX.stepPin = digitalPinToBitMask(stepXpin);

        pinMode(stepYpin, OUTPUT);
        motorY.portStep = portOutputRegister(digitalPinToPort(stepYpin));
        motorY.stepPin = digitalPinToBitMask(stepYpin);

        pinMode(stepZpin, OUTPUT);
        motorZ.portStep = portOutputRegister(digitalPinToPort(stepZpin));
        motorZ.stepPin = digitalPinToBitMask(stepZpin);

        pinMode(esXFrontPin, INPUT_PULLUP);
        motorX.portESF = portInputRegister(digitalPinToPort(esXFrontPin));
        motorX.endStopFrontPin = digitalPinToBitMask(esXFrontPin);

        pinMode(esXEndPin, INPUT_PULLUP);
        motorX.portESE = portInputRegister(digitalPinToPort(esXEndPin));
        motorX.endStopEndPin = digitalPinToBitMask(esXEndPin);

        pinMode(esYFrontPin, INPUT_PULLUP);
        motorY.portESF = portInputRegister(digitalPinToPort(esYFrontPin));
        motorY.endStopFrontPin = digitalPinToBitMask(esYFrontPin);

        pinMode(esYEndPin, INPUT_PULLUP);
        motorY.portESE = portInputRegister(digitalPinToPort(esYEndPin));
        motorY.endStopEndPin = digitalPinToBitMask(esYEndPin);

        pinMode(esZFrontPin, INPUT_PULLUP);
        motorZ.portESF = portInputRegister(digitalPinToPort(esZFrontPin));
        motorZ.endStopFrontPin = digitalPinToBitMask(esZFrontPin);

        pinMode(esZEndPin, INPUT_PULLUP);
        motorZ.portESE = portInputRegister(digitalPinToPort(esZEndPin));
        motorZ.endStopEndPin = digitalPinToBitMask(esZEndPin);
}
};


struct toolheadInfo {
    Position position;
    float z, speed, spindleSpeed;
};


toolheadInfo basicToolHead() {
    toolheadInfo toolHead;
    toolHead.position.x = 0;
    toolHead.position.y = 0;
    toolHead.z = 0;
    toolHead.speed = MAX_SPEED / 4;
    toolHead.spindleSpeed = 0;

    return toolHead;
}

calibration myCalib = calibration();
//change value
volatile bool spindlON = true;


static void timer1Start() {
    noInterrupts();
    TCCR1A = 0;
    TCCR1B = 0;
    TCNT1 = 0;
    TCCR1B = myCalib.presetTCCR1B;
    OCR1A = myCalib.presetOCR1As;
    TIMSK1 |= (1 << OCIE1A);

    interrupts();
}


static void timer1Stop() {
    TIMSK1 &= ~(1 << OCIE1A);
    TCCR1B = 0;
}


void interuptX() {
    if ((!(*myCalib.motorX.portESF & myCalib.motorX.endStopFrontPin) && !(myCalib.ignoreEndstop & 1)) ||
        (!(*myCalib.motorX.portESE & myCalib.motorX.endStopEndPin) && !(myCalib.ignoreEndstop & 2)) ||
        myCalib.curStepX >= myCalib.maxStepX) {
        myCalib.endFreqX();
        myCalib.finishedJob += 1;
        myCalib.curStepX = 0;
        if (!(*myCalib.motorX.portESF & myCalib.motorX.endStopFrontPin)) {
            myCalib.homed = false;
            myCalib.currentEndstopsError |= 1;
        }
        if (!(*myCalib.motorX.portESE & myCalib.motorX.endStopEndPin)) {
            myCalib.homed = false;
            myCalib.currentEndstopsError |= (1 << 1);
        }
        return;
    }

    else {
        if (!myCalib.motorX.movingAwayFromEndStop) {
            *myCalib.motorX.portStep |= (myCalib.motorX.stepPin);
            delayMicroseconds(myCalib.stepTime);
            *myCalib.motorX.portStep &= ~(myCalib.motorX.stepPin);
            myCalib.curStepX += 1;
        }
        return;
    }
}


void rampUpX() {
    if (myCalib.stateRampUpX == 1) {
        if (myCalib.counterX >= myCalib.counterXMax) {
            myCalib.rampingUpX += 1;
            myCalib.counterX = (myCalib.constantX / myCalib.rampingUpX);
        }
        else {
            myCalib.stateRampUpX = 0;
        }
    }

    if (myCalib.stateRampUpX == 2) {
        if (myCalib.rampingUpX > myCalib.endStepsX) {
            myCalib.rampingUpX -= 1;
            myCalib.counterX = (myCalib.constantX / myCalib.rampingUpX);
        }

        else {
            myCalib.stateRampUpX = 0;
        }
    }
}


void interuptY() {
    if ((!(*myCalib.motorY.portESF & myCalib.motorY.endStopFrontPin) && !(myCalib.ignoreEndstop & 4)) ||
        (!(*myCalib.motorY.portESE & myCalib.motorY.endStopEndPin) && !(myCalib.ignoreEndstop & 8)) || myCalib.curStepY >= myCalib.maxStepY) {
        myCalib.endFreqY();
        myCalib.finishedJob += 1;
        myCalib.curStepY = 0;
        if (!(*myCalib.motorY.portESF & myCalib.motorY.endStopFrontPin)) {
            myCalib.homed = false;
            myCalib.currentEndstopsError |= (1 << 2);
        }
        if (!(*myCalib.motorY.portESE & myCalib.motorY.endStopEndPin)) {
            myCalib.homed = false;
            myCalib.currentEndstopsError |= (1 << 3);
        }
        return;
    }

    else {
        if (!myCalib.motorY.movingAwayFromEndStop) {
            *myCalib.motorY.portStep |= (myCalib.motorY.stepPin);
            delayMicroseconds(myCalib.stepTime);
            *myCalib.motorY.portStep &= ~(myCalib.motorY.stepPin);
            myCalib.curStepY += 1;
        }
        return;
    }
}


void rampUpY() {
    if (myCalib.stateRampUpY == 1) {
        if (myCalib.counterY >= myCalib.counterYMax) {
            myCalib.rampingUpY += 1;
            myCalib.counterY = (myCalib.constantY / myCalib.rampingUpY);
        }
        else {
            myCalib.stateRampUpY = 0;
        }
    }

    if (myCalib.stateRampUpY == 2) {
        if (myCalib.rampingUpY > myCalib.endStepsY) {
            myCalib.rampingUpY -= 1;
            myCalib.counterY = (myCalib.constantY / myCalib.rampingUpY);
        }

        else {
            myCalib.stateRampUpY = 0;
        }
    }
}


void interuptZ() {
    if ((!(*myCalib.motorZ.portESF & myCalib.motorZ.endStopFrontPin) && !(myCalib.ignoreEndstop & 16)) || (!(*myCalib.motorZ.portESE & myCalib.motorZ.endStopEndPin) && !(myCalib.ignoreEndstop & 32))
        || myCalib.curStepZ >= myCalib.maxStepZ) {
        myCalib.endFreqZ();
        myCalib.finishedJob += 1;
        myCalib.curStepZ = 0;
        if (!(*myCalib.motorZ.portESF & myCalib.motorZ.endStopFrontPin)) {
            myCalib.homed = false;
            myCalib.currentEndstopsError |= (1 << 4);
        }
        if (!(*myCalib.motorZ.portESE & myCalib.motorZ.endStopEndPin)) {
            myCalib.homed = false;
            myCalib.currentEndstopsError |= (1 << 5);
        }
        return;
    }

    else {
        if (!myCalib.motorZ.movingAwayFromEndStop) {
            *myCalib.motorZ.portStep |= myCalib.motorZ.stepPin;
            delayMicroseconds(myCalib.stepTime);
            *myCalib.motorZ.portStep &= ~(myCalib.motorZ.stepPin);
            myCalib.curStepZ += 1;
        }
        return;
    }
}


void rampZ() {
    if (myCalib.stateRampUpZ == 1) {
        if (myCalib.counterZ >= myCalib.counterZMax) {
            myCalib.rampingUpZ += 1;
            myCalib.counterZ = (myCalib.constantZ / myCalib.rampingUpZ);
        }

        else {
            myCalib.stateRampUpZ = 0;
        }
    }

    if (myCalib.stateRampUpZ == 2) {
        if (myCalib.rampingUpZ > myCalib.endStepsZ) {
            myCalib.rampingUpZ -= 1;
            myCalib.counterZ = (myCalib.constantZ / myCalib.rampingUpZ);
        }

        else {
            myCalib.stateRampUpZ = 0;
        }
    }
}


//a single turning off function
void emergencyButtonInterupt() {
    digitalWrite(myCalib.enablePin, HIGH);
    analogWrite(SPINDL_PIN, 0);
    spindlON = false;
    myCalib.endFreqX();
    myCalib.endFreqY();
    myCalib.endFreqZ();
    timer1Stop();
    myCalib.currentError = 10;
    myCalib.finishedJob = 5;
}


ISR(TIMER1_COMPA_vect) {
    myCalib.stepAcc += 1;
    if (myCalib.stepAcc >= myCalib.stepAccMax) {
        myCalib.stepAcc = 0;
        rampUpX();
        rampUpY();
        rampZ();
    }

    if (myCalib.clockX == 1) {
        myCalib.countingX += 1;
        if (myCalib.counterX <= myCalib.countingX) {
            myCalib.countingX = 0;
            interuptX();
            if (myCalib.stateRampUpX == 1) {
                myCalib.startStepsX += 1;
                if (myCalib.curStepX + 1 >= (myCalib.maxStepX/2)) {
                    myCalib.stateRampUpX = 2;
                }
            }

            if (myCalib.stateRampUpX == 0) {
                if (myCalib.curStepX + myCalib.startStepsX >= myCalib.maxStepX) {
                    myCalib.stateRampUpX = 2;
                }
            }
        }
    }

    if (myCalib.clockY == 1) {
        myCalib.countingY += 1;
        if (myCalib.counterY <= myCalib.countingY) {
            myCalib.countingY = 0;
            interuptY();
            if (myCalib.stateRampUpY == 1) {
                myCalib.startStepsY += 1;
                if (myCalib.curStepY + 1 >= (myCalib.maxStepY/2)) {
                    myCalib.stateRampUpY = 2;
                }
            }

            if (myCalib.stateRampUpY == 0) {
                if (myCalib.curStepY + myCalib.startStepsY >= myCalib.maxStepY) {
                    myCalib.stateRampUpY = 2;
                }
            }
        }
    }

    if (myCalib.clockZ == 1) {
        myCalib.countingZ += 1;
        if (myCalib.counterZ <= myCalib.countingZ) {
            myCalib.countingZ = 0;
            interuptZ();
            if (myCalib.stateRampUpZ == 1) {
                myCalib.startStepsZ += 1;
                if (myCalib.curStepZ + 1 >= (myCalib.maxStepZ/2)) {
                    myCalib.stateRampUpZ = 2;
                }
            }

            if (myCalib.stateRampUpZ == 0) {
                if (myCalib.curStepZ + myCalib.startStepsZ >= myCalib.maxStepZ) {
                    myCalib.stateRampUpZ = 2;
                }
            }
        }
    }
}


float loadNum(char *buffer, size_t size, int &currentChar) {
    float oneNumber = 0;
    float floatinDecimal = 0;
    bool negativity = false;
    bool fullNum = false;
    char curChar = ' ';

    while (currentChar < size) {
        curChar = buffer[currentChar];
        if (std::isdigit(curChar)) {
            break;
        }

        if (curChar == '-') {
            negativity = true;
        }

        currentChar += 1;
    }

    while (currentChar < size) {
        curChar = buffer[currentChar];
        if (!(std::isdigit(curChar)) && !(curChar == '.')) {
            break;
        }

        if (curChar == '.' && !fullNum) {
            fullNum = true;
            currentChar += 1;
            continue;
        }

        if (fullNum) {
            floatinDecimal += 1;
        }

        oneNumber *= 10;
        oneNumber += int(curChar - '0');
        currentChar += 1;

        if (currentChar >= size) {
            break;
        }
    }

    oneNumber /= powf(10.0f, floatinDecimal);
    if (negativity) {
        oneNumber *= -1;
    }

    return oneNumber;
}


struct cnc {
    toolheadInfo myToolHead;
    std::array<uint8_t, 7> motorPins; // enable, X step, X dir, Y .... Z ...
    float conversionConst;
    std::array<uint8_t, 6> endStop;

    // Stejne hodnoty jako v nanoComm (uartComm) - protokol je na obou stranach
    // stejny. Nejdelsi ramec (echo reportu od nanoComm) ma i s $ a \n 62 B.
    static constexpr int largeMessageStandart = 80;
    static constexpr int conformationMessageStandart = 20;

    // Kolikrat se report posle, nez to Nano vzda (doplnil Claude). Nano nesmi
    // cekat naporad: kdyz nanoComm report necte, zustalo by viset tady
    // a nevzalo by uz zadny dalsi prikaz.
    static constexpr uint8_t maxReportAttempts = 3;

    char cmdBuf[largeMessageStandart] = {};
    char confBuf[conformationMessageStandart] = {};
    nanoReport report;
    basicCMD cmd;

    // Jestli loadCMD opravdu prijal ramec, nebo jen vyprsel Serial.find
    // (doplnil Claude). Bez toho by nesel rozlisit timeout od prijateho cmd 12.
    bool frameReceived = false;

    cnc(std::array<uint8_t, 7> motorPins, std::array<uint8_t, 6> endStop, uint16_t maxSpindlSpeed = 20000) {
        this->motorPins = motorPins;
        this->endStop = endStop;
        this->conversionConst = 255.0f / (float)maxSpindlSpeed;
        myToolHead = basicToolHead();
    }

    void initialate() {
        Serial.begin(115200);
        delay(2500);
        Serial.setTimeout(1000);
        //Serial.println("Succesfully initialized baundrate");
        delay(100);
        timer1Start();
        myCalib.setupPins(motorPins[0],motorPins[1],motorPins[2],endStop[0],endStop[1],
            motorPins[3],motorPins[4],endStop[2],endStop[3],motorPins[5],motorPins[6],endStop[4],endStop[5]);
        digitalWrite(myCalib.enablePin, LOW);
        myCalib.finishedJob = 0;
        //pinMode(EMERGENCY_PIN, INPUT_PULLUP);
        //attachInterrupt(digitalPinToInterrupt(EMERGENCY_PIN), emergencyButtonInterupt, FALLING);
        //Serial.println("initialized baundrate emergency etc...");
    }

    void operateCMD5(basicCMD &cmd) {
        moveZ(cmd.z);
        move2D(cmd.position);
    }

    // Odjeti z endstopu. Cte zalatchovane bity, ktere nastavil interupt*():
    // 0 Xmin, 1 Xmax, 2 Ymin, 3 Ymax, 4 Zmin, 5 Zmax.
    void moveFromEndstops() {
        if (myCalib.currentEndstopsError == 0) {
            return;
        }

        Position target = {-1, -1};
        float targetZ = -1;
        myToolHead.speed = MAX_SPEED / 2;
        if (myCalib.currentEndstopsError & 1) {
            myToolHead.position.x = 0;
            target.x = MINIMAL_DISTANCE_MM_X;
            myCalib.ignoreEndstop |= 1;
        }

        else if (myCalib.currentEndstopsError & (1 << 1)) {
            myToolHead.position.x = myCalib.maxX + MINIMAL_DISTANCE_MM_X;
            target.x = myCalib.maxX;
            myCalib.ignoreEndstop |= 2;
        }

        if (myCalib.currentEndstopsError & (1 << 2)) {
            myToolHead.position.y = 0;
            target.y = MINIMAL_DISTANCE_MM_Y;
            myCalib.ignoreEndstop |= 4;
        }

        else if (myCalib.currentEndstopsError & (1 << 3)) {
            myToolHead.position.y = myCalib.maxY + MINIMAL_DISTANCE_MM_Y;
            target.y = myCalib.maxY;
            myCalib.ignoreEndstop |= 8;
        }

        if (myCalib.currentEndstopsError & (1 << 4)) {
            myToolHead.z = 0;
            targetZ = MINIMAL_DISTANCE_MM_Z;
            myCalib.ignoreEndstop |= 16;
        }
        else if (myCalib.currentEndstopsError & (1 << 5)) {
            myToolHead.z = myCalib.maxZ + MINIMAL_DISTANCE_MM_Z;
            targetZ = myCalib.maxZ;
            myCalib.ignoreEndstop |= 32;
        }

        if (targetZ != -1) {
            moveZ(targetZ);
        }

        if (target.x != -1 || target.y != -1) {
            move2D(target);
        }
        myCalib.ignoreEndstop = 0;
    }

    void home(bool dir) {
        myCalib.finishedJob = 0;
        controlSpindl(0);
        myCalib.maxStepZ = 32000;
        myCalib.maxStepY = 32000;
        myCalib.maxStepX = 32000;
        if (dir) {
            digitalWrite(myCalib.motorX.dirPin, HIGH);
            digitalWrite(myCalib.motorY.dirPin, HIGH);
            digitalWrite(myCalib.motorZ.dirPin, HIGH);
        }

        else {
            digitalWrite(myCalib.motorX.dirPin, LOW);
            digitalWrite(myCalib.motorY.dirPin, LOW);
            digitalWrite(myCalib.motorZ.dirPin, LOW);
        }

        int freqZ = int((MAX_SPEED_Z/2) * myCalib.stepLenghtT8) / 2;
        int freqXY = int(MAX_SPEED * myCalib.stepLenghtGT2) / 2;

        myCalib.setupFreqZ(freqZ);
        while (myCalib.finishedJob < 1) {
            //wait
        }

        myCalib.finishedJob = 0;
        myCalib.setupFreqY(freqXY);
        while (myCalib.finishedJob < 1) {
            //wait
        }

        myCalib.finishedJob = 0;
        myCalib.setupFreqX(freqXY);
        while (myCalib.finishedJob < 1) {
            //wait
        }

        if (dir) {
            myToolHead.position.x = myCalib.maxX;
            myToolHead.position.y = myCalib.maxY;
            myToolHead.z = myCalib.maxZ;
        }

        else {
            myToolHead.position.x = 0;
            myToolHead.position.y = 0;
            myToolHead.z = 0;
        }
        myCalib.finishedJob = 0;
        moveFromEndstops();
        myCalib.homed = true;
    }

    void clampLocation(Position &location) {
        if (location.x > myCalib.maxX + MINIMAL_DISTANCE_MM_X + .1) {
            location.x = myCalib.maxX;
            myCalib.currentError = 6;
        }

        if (location.y > myCalib.maxY + MINIMAL_DISTANCE_MM_Y + .1) {
            location.y = myCalib.maxY;
            myCalib.currentError = 6;
        }

        if (location.x < MINIMAL_DISTANCE_MM_X-.1) {
            location.x = MINIMAL_DISTANCE_MM_X-.1;
            myCalib.currentError = 6;
        }

        if (location.y < MINIMAL_DISTANCE_MM_Y-.1) {
            location.y = MINIMAL_DISTANCE_MM_Y-.1;
            myCalib.currentError = 6;
        }
    }

    void clampZ(float &z) {
        if (z > myCalib.maxZ + MINIMAL_DISTANCE_MM_Z + .1) {
            z = myCalib.maxZ;
            myCalib.currentError = 6;
        }

        if (z < MINIMAL_DISTANCE_MM_Z -.1) {
            z = MINIMAL_DISTANCE_MM_Z-.1;
            myCalib.currentError = 6;
        }
    }

    void operateInstr() {
        myCalib.finishedJob = 0;
        myCalib.currentError = 0;
        myCalib.currentEndstopsError = 0;
        //Serial.print("Loading instruction");
        basicCMD cmd = loadCMD();

        // Prijaty prikaz se nejdriv posle zpatky a provede se az na potvrzeni
        // od nanoComm (doplnil Claude). Na "ne" nanoComm posle prikaz znovu,
        // takze se tenhle jen zahodi - bez reportu, stejne jako cmd 12.
        if (frameReceived && !MakeSureCMD(cmd)) {
            return;
        }

        //Serial.print("Operating instruction");

        if ((cmd.speed >= .1) && (cmd.command != 2)) {
            if (cmd.speed > MAX_SPEED) {
                cmd.speed = MAX_SPEED;
            }
            myToolHead.speed = cmd.speed;
        }

        if (cmd.spindleSpeed <= -0.5) {
            controlSpindl(myToolHead.spindleSpeed);
        }

        if ((cmd.spindleSpeed >= -.5) && (cmd.command != 6)) {
            controlSpindl(cmd.spindleSpeed);
        }

        if (cmd.command == 1) {
            move2D(cmd.position);
            if (cmd.z >= -.5) {
                moveZ(cmd.z);
            }
        }

        //pokud je to 9, tak musime udelat instrukci znova
        else if (cmd.command == 0) {
            myCalib.currentError = 4;
        }

        else if (cmd.command == 2) {
            controlSpindl(cmd.spindleSpeed);
        }

        else if (cmd.command == 5) {
            operateCMD5(cmd);
        }

        else if (cmd.command == 3) {
            home(false);
        }

        else if (cmd.command == 4) {
            home(true);
        }

        else if (cmd.command == 6) {
            controlSpindl(0);
        }

        else if (cmd.command == 7 || cmd.command == 255) {
            controlSpindl(0);
            home(true);
            myCalib.currentError = 8;
        }

        else if (cmd.command == 8) {
            cmd.position.x += myToolHead.position.x;
            cmd.position.y += myToolHead.position.y;
            cmd.z += myToolHead.z;
            clampLocation(cmd.position);
            clampZ(cmd.z);
            operateCMD5(cmd);
        }

        else if (cmd.command == 25) {
            myCalib.currentError = 3;
        }

        else if (cmd.command == 12) {
            //Serial.println("No instruction skipping");
            return;
        }

        else {
            myCalib.currentError = 5;
        }

        moveFromEndstops();
        //Serial.println("Sending report");
        report = nanoReport(0, myCalib.currentError, {myToolHead.position.x, myToolHead.position.y,}, myToolHead.z, myToolHead.speed, myToolHead.spindleSpeed, myCalib.currentEndstopsError);
        sendNanoReport();
    }

    basicCMD loadCMD() {
        basicCMD returningCMD = basicCMD();
        size_t len;
        frameReceived = false;
        //Serial.print("Loading S");
        memset(cmdBuf, 0, sizeof(cmdBuf));
        if (Serial.find('$')) {
            frameReceived = true;
            //Serial.print("Loading L");
            len = Serial.readBytesUntil('\n', cmdBuf, sizeof(cmdBuf) - 1);
            cmdBuf[len] = '\0';
            int curChar = 0;
            returningCMD.command = loadNum(cmdBuf, len, curChar);
            if (cmdBuf[curChar] == ';') {
                curChar += 1;
            }

            else {
                return basicCMD(25);
            }

            returningCMD.position.x = loadNum(cmdBuf, len, curChar);
            if (cmdBuf[curChar] == ';') {
                curChar += 1;
            }

            else {
                return basicCMD(25);
            }

            returningCMD.position.y = loadNum(cmdBuf, len, curChar);
            if (cmdBuf[curChar] == ';') {
                curChar += 1;
            }

            else {
                return basicCMD(25);
            }
            returningCMD.z = loadNum(cmdBuf, len, curChar);
            if (cmdBuf[curChar] == ';') {
                curChar += 1;
            }

            else {
                return basicCMD(25);
            }

            returningCMD.speed = loadNum(cmdBuf, len, curChar);
            if (cmdBuf[curChar] == ';') {
                curChar += 1;
            }

            else {
                return basicCMD(25);
            }

            returningCMD.spindleSpeed = loadNum(cmdBuf, len, curChar);

            if (cmdBuf[curChar] == ';') {
                curChar += 1;
            }

            else {
                return basicCMD(25);
            }
        }

        else {
            //Serial.println("Parse failed");
        }
        //Serial.print("Loading E");
        return returningCMD;
    }

    // Opakovani a potvrzeni doplnil Claude. Na "ne" nebo kdyz echo neprijde,
    // posle se report znovu - nejvys maxReportAttempts krat.
    void sendNanoReport() {
        for (uint8_t attempt = 0; attempt < maxReportAttempts; attempt++) {
            memset(cmdBuf, 0, sizeof(cmdBuf));
            report.prepareForRPI(cmdBuf, sizeof(cmdBuf));
            Serial.write(cmdBuf, strlen(cmdBuf));

            if (sendReportConfirmation()) {
                return;
            }
        }
    }

    //function created by Claude
    // Kopie hasMajority z nanoComm. V potvrzeni je 14x stejna cifra, takze
    // jeden dva poskozene znaky rozhodnuti nezmeni. Remiza je "ne".
    bool hasMajority(const char conformation[], size_t len) {
        int numOfOnes = 0;
        int numOfZeros = 0;
        for (size_t i = 0; i < len; i++) {
            if (conformation[i] == '1') {
                numOfOnes += 1;
            }

            else if (conformation[i] == '0') {
                numOfZeros += 1;
            }
        }

        return numOfOnes > numOfZeros;
    }

    //function created by Claude
    // Kopie z nanoComm: "$$$", 14x stejna cifra a "\n\n\n", celkem
    // conformationMessageStandart bajtu.
    void sendOnesOrZeros(int toSend) {
        for (int i = 0; i < conformationMessageStandart; i++) {
            if (i < 3) {
                confBuf[i] = '$';
            }
            else if (i >= conformationMessageStandart - 3) {
                confBuf[i] = '\n';
            }
            else {
                confBuf[i] = '0' + toSend;
            }
        }
        Serial.write(confBuf, conformationMessageStandart);
    }

    //function created by Claude
    // Potvrzeni jsou jen cifry 0/1. Sum z nich par poskodi, zahodi nebo prida
    // bajt navic - to vetsina unese, proto se nehlida presna delka. Prikaz
    // i report ale vzdycky obsahuji ';', takze se od potvrzeni poznaji porad.
    // Aspon 10 cifer ze 14, jinak je to spis smeti nez potvrzeni.
    bool looksLikeConformation(const char buf[], size_t len) {
        int digits = 0;
        for (size_t i = 0; i < len; i++) {
            if (buf[i] == ';') {
                return false;
            }
            if (buf[i] == '0' || buf[i] == '1') {
                digits += 1;
            }
        }
        return digits >= conformationMessageStandart - 10;
    }

    //function created by Claude
    // Protejsek MakeSureReport z nanoComm: posle prijaty prikaz zpatky a pocka,
    // jestli ho nanoComm uzna za stejny. true jen na jasne "ano" - cokoliv
    // jineho (timeout, poskozene potvrzeni) znamena, ze se prikaz neprovede.
    bool MakeSureCMD(basicCMD &cmd) {
        memset(cmdBuf, 0, sizeof(cmdBuf));
        cmd.prepareForRPI(cmdBuf, largeMessageStandart * sizeof(char));
        Serial.write(cmdBuf, strlen(cmdBuf));

        if (!Serial.find('$')) {
            return false;
        }

        char conformation[conformationMessageStandart] = {};
        size_t len = Serial.readBytesUntil('\n', conformation, conformationMessageStandart - 1);

        // Cokoliv, co nevypada jako potvrzeni - treba znovu poslany prikaz, kdyz
        // nanoComm echo nedostal - se bere jako "ne", at se omylem nic
        // neprovede. Zbytek delsiho ramce smete pristi Serial.find('$').
        if (!looksLikeConformation(conformation, len)) {
            return false;
        }

        return hasMajority(conformation, len);
    }

    //function created by Claude
    // Rozparsuje report, ktery nanoComm poslal zpatky. Stejne poradi poli jako
    // nanoReport::prepareForRPI, jen hodnoty jsou uz v mm (nanoComm je vydelil
    // stem). Kazde pole musi koncit ';', jinak je ramec rozbity.
    bool loadReport(char *buffer, size_t len, nanoReport &echoed) {
        float fields[8];
        int curChar = 0;
        for (uint8_t i = 0; i < 8; i++) {
            fields[i] = loadNum(buffer, len, curChar);
            if (buffer[curChar] != ';') {
                return false;
            }
            curChar += 1;
        }

        echoed = nanoReport(fields[0], fields[1], {fields[2], fields[3]}, fields[4],
            fields[5], fields[6], fields[7]);
        return true;
    }

    //function created by Claude
    // Nano posila long(x * 100), nanoComm to vydeli stem a posle zpatky, takze
    // po lround(x * 100) musi vyjit presne stejne cele cislo. Tolerance tu
    // proto neni potreba a nic se neschova pod ni.
    bool sameHundredths(float sent, float echoed) {
        return long(sent * 100) == lround(echoed * 100);
    }

    //function created by Claude
    // Protejsek sameCMDs z nanoComm.
    bool sameReports(const nanoReport &sent, const nanoReport &echoed) {
        return sent.status == echoed.status
            && sent.error == echoed.error
            && sent.endstops == echoed.endstops
            && sameHundredths(sent.position.x, echoed.position.x)
            && sameHundredths(sent.position.y, echoed.position.y)
            && sameHundredths(sent.z, echoed.z)
            && sameHundredths(sent.speed, echoed.speed)
            && sameHundredths(sent.spindleSpeed, echoed.spindleSpeed);
    }

    //function created by Claude
    // Protejsek sendCMDConfirmation z nanoComm: precte report, ktery nanoComm
    // poslal zpatky, porovna ho s odeslanym a odpovi 14x "1" nebo 14x "0".
    // Kdyz echo neprijde vubec, nic neposila - report se proste posle znovu.
    bool sendReportConfirmation() {
        memset(cmdBuf, 0, sizeof(cmdBuf));
        if (!Serial.find('$')) {
            return false;
        }

        size_t len = Serial.readBytesUntil('\n', cmdBuf, sizeof(cmdBuf) - 1);
        cmdBuf[len] = '\0';

        nanoReport echoed;
        if (loadReport(cmdBuf, len, echoed) && sameReports(report, echoed)) {
            sendOnesOrZeros(1);
            return true;
        }

        sendOnesOrZeros(0);
        return false;
    }

    void moveZ(float z) {
        myCalib.finishedJob = 1;
        if (z == myToolHead.z || z <= -.5) {
            return;
        }


        clampZ(z);

        if (myToolHead.speed <= 0.1) {
            myToolHead.speed = 0.1;
        }
        if (z >= myToolHead.z) {
            digitalWrite(myCalib.motorZ.dirPin, HIGH);
        }

        else {
            digitalWrite(myCalib.motorZ.dirPin, LOW);
        }

        int freqZ;

        if (myToolHead.speed >= MAX_SPEED_Z) {
            freqZ = int(20 * myCalib.stepLenghtT8);
        }
        else {
            freqZ = int(myToolHead.speed * myCalib.stepLenghtT8);
        }
        float lenghtZ = z - myToolHead.z;
        myCalib.maxStepZ = (int)(myCalib.stepLenghtT8 * fabs(lenghtZ) + 0.5f);

        myCalib.finishedJob -= 1;
        myCalib.setupFreqZ(freqZ);


        while (myCalib.finishedJob < 1) {
            //wait
        }

        if (!myCalib.homed) {
            myCalib.currentError = 7;
        }

        myToolHead.z += ((float)myCalib.maxStepZ / myCalib.stepLenghtT8) * copysign(1.0f, lenghtZ);
    }

    void move2D(Position location) {
        myCalib.finishedJob = 2;
        if (location.x < -.5) {
            location.x = myToolHead.position.x;
        }

        if (location.y < -.5) {
            location.y = myToolHead.position.y;
        }

        clampLocation(location);

        if (myToolHead.speed <= 0.1) {
            myToolHead.speed = 0.1;
        }

        if (location.x >= myToolHead.position.x) {
            digitalWrite(myCalib.motorX.dirPin, HIGH);
        }

        else {
            digitalWrite(myCalib.motorX.dirPin, LOW);
        }

        if (location.y >= myToolHead.position.y) {
            digitalWrite(myCalib.motorY.dirPin, HIGH);
        }

        else {
            digitalWrite(myCalib.motorY.dirPin, LOW);
        }

        float lenghtX = location.x - myToolHead.position.x;
        float lenghtY = location.y - myToolHead.position.y;
        float lenght = sqrt(pow((lenghtX), 2) + pow((lenghtY), 2));
        float totalTime = lenght / myToolHead.speed;
        myCalib.maxStepX = abs(myCalib.stepLenghtGT2 * lenghtX);
        myCalib.maxStepY = abs(myCalib.stepLenghtGT2 * lenghtY);
        int freqX = int(myCalib.maxStepX / totalTime); // matematicky prepis tohodle:  1 / (totalTime / totalStepsX)
        int freqY = int(myCalib.maxStepY / totalTime);

        if (freqX == 0 && myCalib.maxStepX > 0) {
            freqX = 1;
        }

        if (freqY == 0 && myCalib.maxStepY > 0) {
            freqY = 1;
        }

        if (freqX != 0) {
            myCalib.finishedJob -= 1;
        }

        if (freqY != 0) {
            myCalib.finishedJob -= 1;
        }

        if (freqX != 0) {
            myCalib.setupFreqX(freqX);
        }

        if (freqY != 0) {
            myCalib.setupFreqY(freqY);
        }

        while (myCalib.finishedJob < 2) {
            //wait
        }

        if (!myCalib.homed) {
            myCalib.currentError = 7;
        }

        // Pozice se smi pricist jen tam, kde se opravdu krokovalo. S pojistkou
        // vyse uz freq == 0 pri maxStep > 0 nenastane, tohle je levna ochrana
        // proti tomu, aby se ta chyba zase zacala tise scitat.
        if (freqX != 0) {
            myToolHead.position.x += ((float)myCalib.maxStepX / myCalib.stepLenghtGT2) * copysign(1.0f, lenghtX);
        }

        if (freqY != 0) {
            myToolHead.position.y += (((float)myCalib.maxStepY / myCalib.stepLenghtGT2) * copysign(1.0f, lenghtY));
        }
    }

    void controlSpindl(int speed) {
        if (speed == -1) {
            return;
        }
        if (spindlON) {
            myToolHead.spindleSpeed = speed;
            speed = (int)((float)speed * conversionConst);
            if (speed <= 0) {
                digitalWrite(SPINDL_PIN, LOW);
                return;
            }
            if (speed >= 255) {
                digitalWrite(SPINDL_PIN, HIGH);
                return;
            }
            analogWrite(SPINDL_PIN, speed);
        }
        else {
            myToolHead.spindleSpeed = 555;
        }
    }
};


cnc myCNC = cnc({3,4,5,6,7,8,9}, {10,16,17,18,14,15});

void setup() {
    pinMode(19, OUTPUT);
    digitalWrite(19, HIGH);
    myCNC.initialate();
}

void loop() {
    digitalWrite(19, !digitalRead(19));
    myCNC.operateInstr();
}
